asrvsn/mmi/bom.xlsx

Sheet: BOM
Component | Name | Required per unit | X units | Quantity obtained | Ordered | Total cost | Link | Supplier | Notes
Controller | Raspberry Pi 5, 2 GB (SC1642) | 1 | 1 |  | FALSE |  | https://thepihut.com/products/raspberry-pi-5?variant=43878483198147 | The Pi Hut | The desk-side controller. Any PC with an Ethernet port can drive the unit instead. Needs a 5 V 3 A USB-C supply (the USB-C plugs under Global).
Controller | Lexar 64 GB microSD card | 1 | 1 |  | FALSE |  | https://www.amazon.co.uk/dp/B0BX9BH17W | Amazon | For the Raspberry Pi.
Controller | Pimoroni HyperPixel 4.0 display, 800 x 480, touchscreen (PIM369) | 1 | 1 |  | FALSE |  | https://thepihut.com/products/hyperpixel?variant=696832262161 | The Pi Hut | The controller's status display, on the Pi's 40-pin header. The non-touch version (PIM370) works too.
Controller | Raspberry Pi Micro-HDMI to HDMI cable, 2 m, black (SC0532) | 1 | 1 |  | FALSE |  | https://thepihut.com/products/micro-hdmi-to-standard-hdmi-a-cable?variant=31597425033278 | The Pi Hut | From the Pi 5 to a desk monitor. The Pi 5's video ports are micro-HDMI, not mini-HDMI. A 1 m version also exists (black SC0546, white SC0358).
Controller | 8BitDo Ultimate 2C Wired controller (PC/Android): Hall effect sticks and triggers, 1000 Hz, USB | 1 | 1 |  | FALSE |  | https://www.amazon.co.uk/dp/B0D72WYT8Z?th=1 | Amazon | The hand controls, on the Pi's USB. Hall-effect sticks don't drift the way potentiometer sticks do. Also at Scan, LN154462.
Global | Neodymium disc magnet, 8 x 3 mm, N42, axially magnetised, Ni-Cu-Ni (MS0118) | 9 | 3 |  | FALSE |  | https://magnetstore.co.uk/disc-magnets/8mm-x-3mm-neodymium-disc-magnet-n42/ | Magnet Store | 9 per unit, one under each V-slot of the three magnetic kinematic couplings.
Global | Dowel pin, 2 x 10 mm, DIN 6325 m6, hardened and ground steel | 24 | 3 |  | FALSE |  | https://springfasteners.co.uk/product/solid-dowel-pin-din-6325-2mm-x-10mm/ | Spring Fasteners | 24 per unit: 4 kinematic couplings x 3 contacts x 2 dowels. Must be magnetic: hardened steel, not A1/A2/A4 stainless. Sold in packs of 5-100.
Global | Steel ball, 8 mm, AISI 440C, grade G100 | 12 | 3 |  | FALSE |  | https://www.ballandrollerstore.com/stainless-steel-aisi-440c-ball-bearings/8mm-aisi-440c/ | Ball and Roller Store | 12 per unit: 4 kinematic couplings x 3 contacts. 440C is hard, magnetic and corrosion resistant.
Global | Formlabs Rigid 4000 resin, 1 L cartridge | 2 | 1 |  | FALSE |  | https://www.additive-x.com/shop/form-2-rigid-4000-resin-cartridge-1l.html | Additive-X | For the printed parts (Form 3L).
Global | VooGenzek PCB prototyping kit: 20 perfboards, 2/3-pin screw terminals, male and female pin headers | 1 | 1 |  | FALSE |  | https://www.amazon.co.uk/dp/B09NDP48TX | Amazon | Used for its 2.54 mm pin headers: male for Teensys without pre-assembled headers and the head board's 2x3 test header; female for the Teensy's sockets on the main board, 2 x 1x24 per unit, each cut from a 1x40 strip. Its 8.4 mm female strips work in place of 8.5 mm. More strips in the header kit, next row.
Global | GLARKS 2.54 mm pin header kit, 40 pcs in 8 kinds: 1x40 and 2x40 male, straight and right-angle; 1x40 and 2x40 female; round-pin male and female | 1 | 1 |  | FALSE |  | https://www.amazon.co.uk/dp/B01GY36RJY | Amazon | General header stock, 5 strips of each kind. Its straight female strips add to the VooGenzek kit's for the Teensy's sockets: use the square-pin ones there, not the round-pin. Contents taken from SunFounder's listing of the same kit, so check on arrival.
Global | TUOFENG 26 AWG silicone wire, 6 colours x 10 m | 1 | 1 |  | FALSE |  | https://www.amazon.co.uk/dp/B07G732HNX | Amazon | One set per build: the lid cable (7 strands), the LED strip leads and the head's short motor and switch wires.
Global | Heat-shrink tubing assortment, 2:1, 560 pcs | 1 | 1 |  | FALSE |  | https://www.amazon.co.uk/dp/B092VWZN4W | Amazon | One set per build. Covers the lid cable's solder joints.
Global | 900Pcs Bolts and Nuts Set,M2 M2.5 M3 | 1 | 1 |  | FALSE |  | https://www.amazon.co.uk/dp/B0F38BVTWW | Amazon | The build's M2, M2.5 and M3 screws and nuts. Per unit: 3 x M2.5 screws with nuts or standoffs for the main board, 6 x M3 nuts for the top plate, and M2 screws and nuts for the holder clamp, head board and wrist clamp. The wrist clamp also needs 2 x M2 x 7 countersunk screws per unit, bought separately. Check the kit's lengths on arrival.
Global | M3-0.5x6mm Button Head Socket Cap Screws | 1 | 1 |  | FALSE |  | https://www.amazon.co.uk/dp/B0CNR3XJM9 | Amazon | 6 per unit, for the top plate. Pan or button head: countersunk heads won't seat in the plate's holes. Check the pack covers all your units.
Global | Gocableties cable ties, 100 x 2.5 mm, pack of 100 | 1 | 1 |  | FALSE |  | https://www.amazon.co.uk/dp/B072SLJR2T | Amazon | The head board's ribbon strain relief, plus cable dressing. One pack covers all units.
Global | 1DFAUL conformal coating for electronics, 200 ml | 1 | 1 |  | FALSE |  | https://www.amazon.co.uk/dp/B0FH28CQ2Q?th=1 | Amazon | For the boards. One bottle covers all units.
Global | USB-C PD charger plug, 20 W, UK, 3-pack | 1 | 1 |  | FALSE |  | https://www.amazon.co.uk/dp/B0CFFDWMWZ | Amazon | The Raspberry Pi 5's supply, in place of the official 27 W (SC1154). It must supply 5 V at 3 A, so check the label. If USB-C cables don't come with the plugs, add a USB-C to USB-C cable rated 3 A. One 3-pack covers 3 controllers.
Global | Araldite Standard 2-part epoxy, slow cure, 2 x 15 ml tubes (ARA-400001) | 1 | 1 |  | FALSE |  | https://www.amazon.co.uk/dp/B0F8BJ1MX4 | Amazon | Slow-cure 2-part epoxy, for setting the kinematic coupling hardware (balls, dowels, magnets) into the printed parts. One pack covers all units. Agilent Torr Seal works as a substitute. Avoid fast-setting urethanes such as J-B Weld PlasticBonder: they creep at the coupling seats.
Global | Synthetic grease | 1 | 1 |  | FALSE |  | https://www.amazon.co.uk/dp/B000XBH9HI | Amazon
Global | M4 x 8 mm countersunk bolts, pack of 20 | 3 | 1 |  | FALSE |  | https://www.amazon.co.uk/dp/B0FD2XSKKP | Amazon | Counted in packs: 3 packs of 20.
Global | M4 x 10 mm countersunk bolts, pack of 20 | 3 | 1 |  | FALSE |  | https://www.amazon.co.uk/dp/B0FD316BX3 | Amazon | Counted in packs: 3 packs of 20.
Head | Miniature linear stage, MAX-B34C-13S | 3 | 3 |  | FALSE |  | https://optics-focus.com/product/miniature-linear-stage-1777569712/ | Optics-focus | Non-micrometer version. Older product page: https://optics-focus.com/miniature-linear-stage-p-206.html
Head | INJORA INJS11 11 kg coreless digital micro servo (INJS11GD) | 5 | 2 |  | FALSE |  | https://www.amazon.co.uk/dp/B0FKMPXRCS | Amazon | Bottom wire exit variant. Used as a gearmotor: the servo board is bypassed.
Head | Omron D2F-01FL microswitch, SPDT, hinge lever, low force, gold contacts, PCB terminals | 10 | 4 |  | FALSE |  | https://www.digikey.co.uk/en/products/detail/omron-electronics-inc-emc-div/D2F-01FL/368431 | DigiKey | The head's limit switches, 8 per unit. Low operating force (<= 0.25 N) so it doesn't fight the stages' return springs. Omron's switch line is now sold as Aratas. DigiKey SW858-ND.
Head | Stainless steel balls, 6 mm, G25, 120 pcs | 1 | 1 |  | FALSE |  | https://www.amazon.co.uk/dp/B0GHLXD2JL | Amazon | One pack of 120. A ball that sits on a magnet must be magnetic: 440C or chrome steel, not 304/316 stainless.
Head | Neodymium disc magnet, 6 x 2 mm, N42, 20 pcs | 1 | 1 |  | FALSE |  | https://www.amazon.co.uk/dp/B003MWC1CS | Amazon | One pack of 20.
Head | Neodymium disc magnet, 6 x 3 mm, N42, 20 pcs | 1 | 1 |  | FALSE |  | https://www.amazon.co.uk/dp/B015UQKQQG | Amazon | One pack of 20.
Lid | BQLZR TES1-4902 Peltier module, 20 x 20 x 4 mm, 6 V 2 A, pack of 2 | 5 | 1 |  | FALSE |  | https://www.amazon.co.uk/dp/B0998KCDHK | Amazon | Counted in packs: 3 packs per unit for the lid's six Peltiers (in series). They must be 4.0 mm thick: the top plate sits flush only with 4.0 mm modules. Single-module spares: sourcing map TES1-4902, https://www.amazon.co.uk/dp/B0D1N1H1BR
Lid | TES1-4902 Peltier module, 20 x 20 mm, 6 V 2 A (second supplier) | 2 | 1 |  | FALSE |  | https://www.amazon.co.uk/dp/B098JTRFQ6 | Amazon | A second source for the same module, if the BQLZR packs (previous row) run short. Pack size not checked. Must be 4.0 mm thick. A lid's six Peltiers run in series, so keep each lid's six from one supplier.
Lid | TEWA TT4-G10KC3-T180-C312-200 NTC probe, 10k, 1 %, B 3977, stainless cap 3 x 12 mm, 200 mm PTFE leads | 2 | 5 |  | FALSE |  | https://www.digikey.co.uk/en/products/detail/tewa-sensors-llc/TT4-G10KC3-T180-C312-200/12419127 | DigiKey | The medium temperature probes, 2 per unit. Glass NTC in a 3 mm stainless cap, -40 to 180 C. DigiKey 1912-TT4-G10KC3-T180-C312-200-ND.
Lid | ARCTIC MX-4 thermal paste, 8 g | 1 | 1 |  | FALSE |  | https://www.amazon.co.uk/dp/B07LF66ZSV | Amazon | For the Peltiers. One 8 g syringe covers all units.
Lid | Rust-Oleum Painter's Touch spray paint, matt black, 400 ml | 1 | 1 |  | FALSE |  | https://www.amazon.co.uk/dp/B001W03PH2 | Amazon | For the lid board's aluminium underside. One can covers all units. Any matt black that dries at room temperature works; avoid metallic, graphite or conductive paints, and heat-cure (VHT / High Heat) paints. Also needed: a fine abrasive pad or 600-grit paper, masking tape and paper. The same can at B&Q: https://www.diy.com/departments/rust-oleum-painter-s-touch-black-matt-multi-surface-decorative-spray-paint-400ml/128301_BQ.prd. On an RS order instead: RS PRO 764-3039, https://uk.rs-online.com/web/p/spray-paint/7643039
Lid | Polyimide (Kapton) tape, 15 mm x ~33 m, amber, single-sided | 1 | 1 |  | FALSE |  | https://thepihut.com/products/polyimide-tape?variant=42183571833027 | The Pi Hut | Small pieces under the lid frame's nuts. One roll covers all units. Generic tape is about 0.06 mm thick; up to 0.1 mm works. Pi Hut SKU 105239. Branded alternative, 0.069 mm: 3M 5413 at DigiKey, https://www.digikey.co.uk/en/products/detail/3m/5413-AMBER-1-4-IN-X-36-Y/1819260
Main | Linear stage with NEMA11 stepper, 150 mm stroke, T6x1 lead screw, MGN9 rail | 1 | 3 |  | FALSE |  | https://www.amazon.co.uk/dp/B08Y6YR45F | Amazon | The X coarse rail. Keep the 1 mm lead (T6x1). A generic design made by several factories, so buy all units from one seller in one order.
Main | Teensy 4.1 with Ethernet, pre-assembled headers (PJRC DEV-16996) | 1 | 3 |  | FALSE |  | https://thepihut.com/products/teensy-4-1-with-assembled-pins?variant=37627618066627 | The Pi Hut | The main board's MCU. Also needs the PJRC Ethernet kit (next row) and a Schottky diode for the VUSB-VIN modification (the 1N5819HW, under Main).
Main | PJRC Ethernet Kit for Teensy 4.1: MagJack, bare adaptor board, 6-wire cable, two 2x3 2 mm headers, capacitor | 1 | 3 |  | FALSE |  | https://thepihut.com/products/ethernet-kit-for-teensy-4-1?variant=37627737669827 | The Pi Hut | 1 per unit. Supplies the MagJack, the two 2x3 2 mm headers and the 6-wire cable; the adaptor board and capacitor aren't used.
Main | Ultra-slim Cat6 Ethernet cable, 2.8 mm OD, 3 m, 6-pack | 1 | 1 |  | FALSE |  | https://www.amazon.co.uk/dp/B0FC2N8718 | Amazon | The unit's data link. One 6-pack covers up to 6 units. Avoid flat Ethernet cable: it's stiff in one direction and twists. Faster-delivery fallback: Dutevolns ultra-thin Cat6A, 3.2 mm OD, 3 m, 2-pack, https://www.amazon.co.uk/dp/B0DXT9CQGD
Main | KEXIN 16 GB microSDHC card, Class 10 UHS-I, 5-pack, with SD adapter | 1 | 1 |  | FALSE |  | https://www.amazon.co.uk/dp/B097TBKXZL | Amazon | Counted in packs: one 5-pack covers 3 Teensys' microSD slots, with 2 spares.
Main | Würth 61202021621 WR-BHD box header, 2x10, 2.54 mm, shrouded, straight, through-hole | 1 | 10 |  | FALSE |  | https://www.digikey.co.uk/en/products/detail/w%C3%BCrth-elektronik/61202021621/2060592 | DigiKey | J1, the head ribbon's header, 1 per unit; a spare makes the ribbon test plug. Any straight shrouded 2x10 2.54 mm box header fits, e.g. Sullins SBH11-PBPC-D10-ST-BK (S9172-ND). DigiKey 732-2096-ND.
Main | Panasonic EEU-FR1H101 electrolytic capacitor, 100 uF 50 V, low ESR, radial 8 x 11.5 mm, 3.5 mm pitch | 2 | 10 |  | FALSE |  | https://www.digikey.co.uk/en/products/detail/panasonic-electronic-components/EEU-FR1H101/2433588 | DigiKey | C3 and C12, 2 per unit, hand-fitted. If it's out of stock, the EEU-FM1H101 (P12392-ND) has the same 8 x 11.5 mm can and 3.5 mm pitch. DigiKey P14454-ND.
Main | Diodes Inc 1N5819HW-7-F Schottky diode, SOD-123, 1 A 40 V | 1 | 10 |  | FALSE |  | https://www.digikey.co.uk/en/products/detail/diodes-incorporated/1N5819HW-7-F/815283 | DigiKey | Teensy modification, 1 per unit: bridges the cut VUSB-VIN pads. Any SOD-123 Schottky of 0.5 A or more works, such as the B5819W. DigiKey 1N5819HW-FDICT-ND (cut tape).
Main | Same Sky (CUI) PJ-063AH barrel jack, 5.5 mm, 2.0 mm pin, 8 A, 24 V DC, PCB horizontal | 1 | 10 |  | FALSE |  | https://www.digikey.co.uk/en/products/detail/same-sky-formerly-cui-devices/PJ-063AH/2161208 | DigiKey | J15, the 24 V input, 1 per unit. Order it with its plug (next row). Breadboard-style 2.1 mm jacks don't fit the footprint. DigiKey CP-063AH-ND.
Main | Same Sky (CUI) PP3-002AH DC plug, 5.5 x 2.1 mm, 14 mm barrel, solder eyelets, screw-on cover | 1 | 10 |  | FALSE |  | https://www.digikey.co.uk/en/products/detail/same-sky-formerly-cui-devices/PP3-002AH/2197311 | DigiKey | J15's mating plug, rated 24 V DC / 8 A. Cable OD 4 mm max. DigiKey CP3-002AH-ND. Not the PP3-002A: its 9.5 mm barrel fouls the board, and it's rated only 20 V.
Main | Haerkn 22 AWG silicone 2-core cable, 10 m | 1 | 1 |  | FALSE |  | https://www.amazon.co.uk/dp/B07TT52X28 | Amazon | The 24 V lead from the power supply to the DC plug. One 10 m reel gives 5 units a 2 m lead each. The plug cover takes cable up to 4 mm OD, so check the OD on arrival.
Main | Mean Well LRS-350-24 power supply, 24 V 14.6 A, 350 W, enclosed | 1 | 1 |  | FALSE |  | https://www.digikey.co.uk/en/products/detail/mean-well-usa-inc/LRS-350-24/7705034 | DigiKey | The unit's power supply. Its mains input is screw terminals, so it needs the mains lead (next row). DigiKey 1866-3346-ND. Also at RS UK, 106-5869: https://uk.rs-online.com/web/p/switching-power-supplies/1065869
Main | GlobTek 6104136F000 mains lead, UK plug (BS1363) to bare cable, H05RN-F, 17 AWG, 1.86 m, black | 1 | 1 |  | FALSE |  | https://www.digikey.co.uk/en/products/detail/globtek-inc/6104136F000/9837738 | DigiKey | The power supply's mains lead: UK plug to bare cores for its L, N and earth terminals. One per supply. DigiKey 1939-1673-ND.
Main | JST S7B-PH-K-S header, PH 7-pin, 2.0 mm, side entry, through-hole | 1 | 10 |  | FALSE |  | https://www.digikey.co.uk/en/products/detail/jst-sales-america-inc/S7B-PH-K-S/926631 | DigiKey | J20, the lid port. A spare makes the lid test plug. DigiKey 455-1724-ND.
Main | JST S3B-PH-SM4-TB header, PH 3-pin, 2.0 mm, side entry, SMD | 1 | 10 |  | FALSE |  | https://www.digikey.co.uk/en/products/detail/jst-sales-america-inc/S3B-PH-SM4-TB/926656 | DigiKey | J16, the LED strip port, hand-soldered. DigiKey 455-S3B-PH-SM4-TBCT-ND (cut tape).
Main | WeLoveLEDs COB CCT LED strip, 24 V, 608 LEDs/m, 7 W/m, 10 mm wide (sold per metre) | 1 | 1 |  | FALSE |  | https://www.weloveleds.co.uk/products/cob-cct-led-strip-24v-608leds-7w | WeLoveLEDs | 1 m covers the build. It cuts every 50 mm. Per-metre cuts come without guaranteed leads, so plan to solder your own.
Main | JST S4B-ZR-SM4A-TF header, ZH 4-pin, 1.5 mm, side entry, SMD | 1 | 10 |  | FALSE |  | https://www.digikey.co.uk/en/products/detail/jst-sales-america-inc/S4B-ZR-SM4A-TF/926602 | DigiKey | J3, the rail motor port, hand-soldered. DigiKey 455-S4B-ZR-SM4A-TFCT-ND (cut tape).
Main | JST PHR-7 housing, PH 7-pin, 2.0 mm | 1 | 10 |  | FALSE |  | https://www.digikey.co.uk/en/products/detail/jst-sales-america-inc/PHR-7/608603 | DigiKey | The lid cable's plug for J20. Takes halves of the pre-crimped ASPHSPH24K305 leads, so no crimp tool is needed. DigiKey 455-1161-ND.
Main | JST PHR-3 housing, PH 3-pin, 2.0 mm | 1 | 10 |  | FALSE |  | https://www.digikey.co.uk/en/products/detail/jst-sales-america-inc/PHR-3/527357 | DigiKey | The LED strip's plug for J16, 1 per unit, with halves of the ASPHSPH24K305 leads. Genuine JST, so it mates J16 exactly. DigiKey 455-1126-ND.
Main | JST ASPHSPH24K305 pre-crimped PH lead, 24 AWG, 305 mm, socket both ends | 6 | 5 |  | FALSE |  | https://www.digikey.co.uk/en/products/detail/jst-sales-america-inc/ASPHSPH24K305/6009459 | DigiKey | Pre-crimped wires for the PHR-7 and PHR-3, so no PH crimp tool is needed: each lead cut in half gives two crimped wires. 6 per set: 4 for the lid cable, 2 for the LED strip plug. DigiKey 455-3083-ND.
Main | JST ZHR-4 housing, ZH 4-pin, 1.5 mm | 1 | 10 |  | FALSE |  | https://www.digikey.co.uk/en/products/detail/jst-sales-america-inc/ZHR-4/608643 | DigiKey | The rail motor cable's plug for J3, 1 per unit, with the ASZHSZH28K305 leads. Genuine JST, so it mates J3 exactly. DigiKey 455-1202-ND.
Main | JST ASZHSZH28K305 pre-crimped ZH lead, 28 AWG, 305 mm, socket both ends | 2 | 10 |  | FALSE |  | https://www.digikey.co.uk/en/products/detail/jst-sales-america-inc/ASZHSZH28K305/6009456 | DigiKey | Pre-crimped wires for the ZHR-4, so no ZH crimp tool is needed: each lead cut in half gives two crimped wires, so 2 per cable. Use 4 uncut if the run to the motor is longer. DigiKey 455-3080-ND.
Main | 3M M3AAA-2018J IDC cable, 20-way, socket to socket, 457 mm (18 in) | 1 | 5 |  | FALSE |  | https://www.digikey.co.uk/en/products/detail/3m/M3AAA-2018J/229980 | DigiKey | The head cable, 1 per unit. DigiKey M3AAA-2018J-ND.
Main | sourcing map silicone solid cord, 2 mm, 10m | 1 | 1 |  | FALSE |  | https://www.amazon.co.uk/dp/B0DM5ZPQFH?th=1 | Amazon | The capillary clamp lid's cord, about 0.22 m per unit, so one length covers all units. Despite the listing's 'solid', it's a solid-section sponge, not solid rubber.
Main | C&K SK-12D07-VG 4 NS PA slide switch, SPDT, right angle, through-hole, 2.0 mm pitch, 4 mm handle | 3 | 10 |  | FALSE |  | https://www.digikey.co.uk/en/products/detail/c-k/SK-12D07-VG-4-NS-PA/3861707 | DigiKey | SW9-SW11 (power, lid heater, motors), 3 per unit. DigiKey 108-SK-12D07-VG4NSPA-ND.
Experiment | Hamilton 1000 Series Gastight syringe, 2.5 mL, threaded plunger, Luer tip, Model 1002 TPLT (Hamilton 81441) |  |  |  | FALSE |  | https://www.hamiltoncompany.com/syringes/81441 | Hamilton | Buy as needed; not counted per unit. Luer slip tip, not Luer lock: it push-fits the stopcock's female Luer. No needle included.
Experiment | Cole-Parmer disposable 3-way stopcock, polycarbonate, female x female x male locking Luer, pack of 100 |  |  |  | FALSE |  | https://www.coleparmer.co.uk/i/cole-parmer-disposable-3-way-stopcock-pc-female-x-female-x-male-locking-100-pk/4852336 | Cole-Parmer | Buy as needed; not counted per unit. Cole-Parmer 4852336. Smaller pack: TICOMI 3-way stopcocks with Luer connections, 16-pack, https://www.amazon.co.uk/dp/B0C28HCDZB
Experiment | Tygon E-3603 tubing, 1/16 in ID x 1/8 in OD, 50 ft (Saint-Gobain ACF00002) |  |  |  | FALSE |  | https://www.coleparmer.co.uk/i/tygon-e-3603-tubing-1-16-id-x-1-8-od-50-ft/5010621 | Cole-Parmer | Buy as needed; not counted per unit. Cole-Parmer 5010621. Luer to 1/16 in barb fittings: Cole-Parmer 5010975 (female Luer) and 5011011 (male Luer lock), 10 per pack.
Experiment | Nunc OmniTray single-well plate, non-treated, polystyrene, SBS footprint 128 x 86 mm, with lid, case of 60 (Thermo 242811) |  |  |  | FALSE |  | https://www.fishersci.co.uk/shop/products/nunc-omnitray/10318181 | Fisher Scientific | Buy as needed; not counted per unit. Fisher 10318181. The coverslips (next row) are glued to it with NOA 81 (the row after).
Experiment | Fisherbrand borosilicate coverslips, 22 x 50 mm, No. 1.5 (0.16-0.19 mm), pack of 100 |  |  |  | FALSE |  | https://www.fishersci.co.uk/shop/products/borosilicate-glass-no-1-coverslip-1/12383138 | Fisher Scientific | Buy as needed; not counted per unit. Fisher 12383138 is the No. 1.5; the No. 1 (0.13-0.16 mm) is Fisher 12373128. Larger alternative: Epredia 38 x 50 mm No. 1 (Fisher 16319925).
Experiment | Norland Optical Adhesive NOA 81, UV-curing, 1 oz bottle |  |  |  | FALSE |  | https://www.edmundoptics.co.uk/p/1-oz-application-bottle-of-noa-81/4179/ | Edmund Optics | Buy as needed; not counted per unit. Glues the coverslips to the OmniTray, chosen for its low viscosity (about 300 cps). Its adhesion to plastic is rated only 'fair' and the OmniTray is polystyrene, so test on an offcut first. Fallback: NOA 68, rated 'good to excellent' on plastic, https://www.edmundoptics.co.uk/p/1-oz-application-bottle-of-noa-68/4178/. Cures with 320-380 nm UV (peak 365 nm).
Experiment | Borosilicate glass capillaries, standard wall, with filament, 2.00 mm OD x 1.00 mm ID, 10 cm, 225 per pack (BF200-100-10) |  |  |  | FALSE |  | https://www.wpi-europe.com/products/glass/glass-capillaries/single-barrel-borosilicate-glass-capillaries.aspx | WPI | Buy as needed; not counted per unit. The 2 mm OD glass the design is drawn for. A Sutter part number resold by WPI Europe: pick BF200-100-10 in the page's options table.

Sheet: By supplier
Component | Name | Quantity to order | Ordered | Link | Supplier | Notes
Additive-X | 1 line to order
Global | Formlabs Rigid 4000 resin, 1 L cartridge | 2 |  | https://www.additive-x.com/shop/form-2-rigid-4000-resin-cartridge-1l.html | Additive-X | For the printed parts (Form 3L).
Amazon | 28 lines to order
Controller | Lexar 64 GB microSD card | 1 |  | https://www.amazon.co.uk/dp/B0BX9BH17W | Amazon | For the Raspberry Pi.
Controller | 8BitDo Ultimate 2C Wired controller (PC/Android): Hall effect sticks and triggers, 1000 Hz, USB | 1 |  | https://www.amazon.co.uk/dp/B0D72WYT8Z?th=1 | Amazon | The hand controls, on the Pi's USB. Hall-effect sticks don't drift the way potentiometer sticks do. Also at Scan, LN154462.
Global | VooGenzek PCB prototyping kit: 20 perfboards, 2/3-pin screw terminals, male and female pin headers | 1 |  | https://www.amazon.co.uk/dp/B09NDP48TX | Amazon | Used for its 2.54 mm pin headers: male for Teensys without pre-assembled headers and the head board's 2x3 test header; female for the Teensy's sockets on the main board, 2 x 1x24 per unit, each cut from a 1x40 strip. Its 8.4 mm female strips work in place of 8.5 mm. More strips in the header kit, next row.
Global | GLARKS 2.54 mm pin header kit, 40 pcs in 8 kinds: 1x40 and 2x40 male, straight and right-angle; 1x40 and 2x40 female; round-pin male and female | 1 |  | https://www.amazon.co.uk/dp/B01GY36RJY | Amazon | General header stock, 5 strips of each kind. Its straight female strips add to the VooGenzek kit's for the Teensy's sockets: use the square-pin ones there, not the round-pin. Contents taken from SunFounder's listing of the same kit, so check on arrival.
Global | TUOFENG 26 AWG silicone wire, 6 colours x 10 m | 1 |  | https://www.amazon.co.uk/dp/B07G732HNX | Amazon | One set per build: the lid cable (7 strands), the LED strip leads and the head's short motor and switch wires.
Global | Heat-shrink tubing assortment, 2:1, 560 pcs | 1 |  | https://www.amazon.co.uk/dp/B092VWZN4W | Amazon | One set per build. Covers the lid cable's solder joints.
Global | 900Pcs Bolts and Nuts Set,M2 M2.5 M3 | 1 |  | https://www.amazon.co.uk/dp/B0F38BVTWW | Amazon | The build's M2, M2.5 and M3 screws and nuts. Per unit: 3 x M2.5 screws with nuts or standoffs for the main board, 6 x M3 nuts for the top plate, and M2 screws and nuts for the holder clamp, head board and wrist clamp. The wrist clamp also needs 2 x M2 x 7 countersunk screws per unit, bought separately. Check the kit's lengths on arrival.
Global | M3-0.5x6mm Button Head Socket Cap Screws | 1 |  | https://www.amazon.co.uk/dp/B0CNR3XJM9 | Amazon | 6 per unit, for the top plate. Pan or button head: countersunk heads won't seat in the plate's holes. Check the pack covers all your units.
Global | Gocableties cable ties, 100 x 2.5 mm, pack of 100 | 1 |  | https://www.amazon.co.uk/dp/B072SLJR2T | Amazon | The head board's ribbon strain relief, plus cable dressing. One pack covers all units.
Global | 1DFAUL conformal coating for electronics, 200 ml | 1 |  | https://www.amazon.co.uk/dp/B0FH28CQ2Q?th=1 | Amazon | For the boards. One bottle covers all units.
Global | USB-C PD charger plug, 20 W, UK, 3-pack | 1 |  | https://www.amazon.co.uk/dp/B0CFFDWMWZ | Amazon | The Raspberry Pi 5's supply, in place of the official 27 W (SC1154). It must supply 5 V at 3 A, so check the label. If USB-C cables don't come with the plugs, add a USB-C to USB-C cable rated 3 A. One 3-pack covers 3 controllers.
Global | Araldite Standard 2-part epoxy, slow cure, 2 x 15 ml tubes (ARA-400001) | 1 |  | https://www.amazon.co.uk/dp/B0F8BJ1MX4 | Amazon | Slow-cure 2-part epoxy, for setting the kinematic coupling hardware (balls, dowels, magnets) into the printed parts. One pack covers all units. Agilent Torr Seal works as a substitute. Avoid fast-setting urethanes such as J-B Weld PlasticBonder: they creep at the coupling seats.
Global | Synthetic grease | 1 |  | https://www.amazon.co.uk/dp/B000XBH9HI | Amazon
Global | M4 x 8 mm countersunk bolts, pack of 20 | 3 |  | https://www.amazon.co.uk/dp/B0FD2XSKKP | Amazon | Counted in packs: 3 packs of 20.
Global | M4 x 10 mm countersunk bolts, pack of 20 | 3 |  | https://www.amazon.co.uk/dp/B0FD316BX3 | Amazon | Counted in packs: 3 packs of 20.
Head | INJORA INJS11 11 kg coreless digital micro servo (INJS11GD) | 10 |  | https://www.amazon.co.uk/dp/B0FKMPXRCS | Amazon | Bottom wire exit variant. Used as a gearmotor: the servo board is bypassed.
Head | Stainless steel balls, 6 mm, G25, 120 pcs | 1 |  | https://www.amazon.co.uk/dp/B0GHLXD2JL | Amazon | One pack of 120. A ball that sits on a magnet must be magnetic: 440C or chrome steel, not 304/316 stainless.
Head | Neodymium disc magnet, 6 x 2 mm, N42, 20 pcs | 1 |  | https://www.amazon.co.uk/dp/B003MWC1CS | Amazon | One pack of 20.
Head | Neodymium disc magnet, 6 x 3 mm, N42, 20 pcs | 1 |  | https://www.amazon.co.uk/dp/B015UQKQQG | Amazon | One pack of 20.
Lid | BQLZR TES1-4902 Peltier module, 20 x 20 x 4 mm, 6 V 2 A, pack of 2 | 5 |  | https://www.amazon.co.uk/dp/B0998KCDHK | Amazon | Counted in packs: 3 packs per unit for the lid's six Peltiers (in series). They must be 4.0 mm thick: the top plate sits flush only with 4.0 mm modules. Single-module spares: sourcing map TES1-4902, https://www.amazon.co.uk/dp/B0D1N1H1BR
Lid | TES1-4902 Peltier module, 20 x 20 mm, 6 V 2 A (second supplier) | 2 |  | https://www.amazon.co.uk/dp/B098JTRFQ6 | Amazon | A second source for the same module, if the BQLZR packs (previous row) run short. Pack size not checked. Must be 4.0 mm thick. A lid's six Peltiers run in series, so keep each lid's six from one supplier.
Lid | ARCTIC MX-4 thermal paste, 8 g | 1 |  | https://www.amazon.co.uk/dp/B07LF66ZSV | Amazon | For the Peltiers. One 8 g syringe covers all units.
Lid | Rust-Oleum Painter's Touch spray paint, matt black, 400 ml | 1 |  | https://www.amazon.co.uk/dp/B001W03PH2 | Amazon | For the lid board's aluminium underside. One can covers all units. Any matt black that dries at room temperature works; avoid metallic, graphite or conductive paints, and heat-cure (VHT / High Heat) paints. Also needed: a fine abrasive pad or 600-grit paper, masking tape and paper. The same can at B&Q: https://www.diy.com/departments/rust-oleum-painter-s-touch-black-matt-multi-surface-decorative-spray-paint-400ml/128301_BQ.prd. On an RS order instead: RS PRO 764-3039, https://uk.rs-online.com/web/p/spray-paint/7643039
Main | Linear stage with NEMA11 stepper, 150 mm stroke, T6x1 lead screw, MGN9 rail | 3 |  | https://www.amazon.co.uk/dp/B08Y6YR45F | Amazon | The X coarse rail. Keep the 1 mm lead (T6x1). A generic design made by several factories, so buy all units from one seller in one order.
Main | Ultra-slim Cat6 Ethernet cable, 2.8 mm OD, 3 m, 6-pack | 1 |  | https://www.amazon.co.uk/dp/B0FC2N8718 | Amazon | The unit's data link. One 6-pack covers up to 6 units. Avoid flat Ethernet cable: it's stiff in one direction and twists. Faster-delivery fallback: Dutevolns ultra-thin Cat6A, 3.2 mm OD, 3 m, 2-pack, https://www.amazon.co.uk/dp/B0DXT9CQGD
Main | KEXIN 16 GB microSDHC card, Class 10 UHS-I, 5-pack, with SD adapter | 1 |  | https://www.amazon.co.uk/dp/B097TBKXZL | Amazon | Counted in packs: one 5-pack covers 3 Teensys' microSD slots, with 2 spares.
Main | Haerkn 22 AWG silicone 2-core cable, 10 m | 1 |  | https://www.amazon.co.uk/dp/B07TT52X28 | Amazon | The 24 V lead from the power supply to the DC plug. One 10 m reel gives 5 units a 2 m lead each. The plug cover takes cable up to 4 mm OD, so check the OD on arrival.
Main | sourcing map silicone solid cord, 2 mm, 10m | 1 |  | https://www.amazon.co.uk/dp/B0DM5ZPQFH?th=1 | Amazon | The capillary clamp lid's cord, about 0.22 m per unit, so one length covers all units. Despite the listing's 'solid', it's a solid-section sponge, not solid rubber.
Ball and Roller Store | 1 line to order
Global | Steel ball, 8 mm, AISI 440C, grade G100 | 36 |  | https://www.ballandrollerstore.com/stainless-steel-aisi-440c-ball-bearings/8mm-aisi-440c/ | Ball and Roller Store | 12 per unit: 4 kinematic couplings x 3 contacts. 440C is hard, magnetic and corrosion resistant.
DigiKey | 19 lines to order
Head | Omron D2F-01FL microswitch, SPDT, hinge lever, low force, gold contacts, PCB terminals | 40 |  | https://www.digikey.co.uk/en/products/detail/omron-electronics-inc-emc-div/D2F-01FL/368431 | DigiKey | The head's limit switches, 8 per unit. Low operating force (<= 0.25 N) so it doesn't fight the stages' return springs. Omron's switch line is now sold as Aratas. DigiKey SW858-ND.
Lid | TEWA TT4-G10KC3-T180-C312-200 NTC probe, 10k, 1 %, B 3977, stainless cap 3 x 12 mm, 200 mm PTFE leads | 10 |  | https://www.digikey.co.uk/en/products/detail/tewa-sensors-llc/TT4-G10KC3-T180-C312-200/12419127 | DigiKey | The medium temperature probes, 2 per unit. Glass NTC in a 3 mm stainless cap, -40 to 180 C. DigiKey 1912-TT4-G10KC3-T180-C312-200-ND.
Main | Würth 61202021621 WR-BHD box header, 2x10, 2.54 mm, shrouded, straight, through-hole | 10 |  | https://www.digikey.co.uk/en/products/detail/w%C3%BCrth-elektronik/61202021621/2060592 | DigiKey | J1, the head ribbon's header, 1 per unit; a spare makes the ribbon test plug. Any straight shrouded 2x10 2.54 mm box header fits, e.g. Sullins SBH11-PBPC-D10-ST-BK (S9172-ND). DigiKey 732-2096-ND.
Main | Panasonic EEU-FR1H101 electrolytic capacitor, 100 uF 50 V, low ESR, radial 8 x 11.5 mm, 3.5 mm pitch | 20 |  | https://www.digikey.co.uk/en/products/detail/panasonic-electronic-components/EEU-FR1H101/2433588 | DigiKey | C3 and C12, 2 per unit, hand-fitted. If it's out of stock, the EEU-FM1H101 (P12392-ND) has the same 8 x 11.5 mm can and 3.5 mm pitch. DigiKey P14454-ND.
Main | Diodes Inc 1N5819HW-7-F Schottky diode, SOD-123, 1 A 40 V | 10 |  | https://www.digikey.co.uk/en/products/detail/diodes-incorporated/1N5819HW-7-F/815283 | DigiKey | Teensy modification, 1 per unit: bridges the cut VUSB-VIN pads. Any SOD-123 Schottky of 0.5 A or more works, such as the B5819W. DigiKey 1N5819HW-FDICT-ND (cut tape).
Main | Same Sky (CUI) PJ-063AH barrel jack, 5.5 mm, 2.0 mm pin, 8 A, 24 V DC, PCB horizontal | 10 |  | https://www.digikey.co.uk/en/products/detail/same-sky-formerly-cui-devices/PJ-063AH/2161208 | DigiKey | J15, the 24 V input, 1 per unit. Order it with its plug (next row). Breadboard-style 2.1 mm jacks don't fit the footprint. DigiKey CP-063AH-ND.
Main | Same Sky (CUI) PP3-002AH DC plug, 5.5 x 2.1 mm, 14 mm barrel, solder eyelets, screw-on cover | 10 |  | https://www.digikey.co.uk/en/products/detail/same-sky-formerly-cui-devices/PP3-002AH/2197311 | DigiKey | J15's mating plug, rated 24 V DC / 8 A. Cable OD 4 mm max. DigiKey CP3-002AH-ND. Not the PP3-002A: its 9.5 mm barrel fouls the board, and it's rated only 20 V.
Main | Mean Well LRS-350-24 power supply, 24 V 14.6 A, 350 W, enclosed | 1 |  | https://www.digikey.co.uk/en/products/detail/mean-well-usa-inc/LRS-350-24/7705034 | DigiKey | The unit's power supply. Its mains input is screw terminals, so it needs the mains lead (next row). DigiKey 1866-3346-ND. Also at RS UK, 106-5869: https://uk.rs-online.com/web/p/switching-power-supplies/1065869
Main | GlobTek 6104136F000 mains lead, UK plug (BS1363) to bare cable, H05RN-F, 17 AWG, 1.86 m, black | 1 |  | https://www.digikey.co.uk/en/products/detail/globtek-inc/6104136F000/9837738 | DigiKey | The power supply's mains lead: UK plug to bare cores for its L, N and earth terminals. One per supply. DigiKey 1939-1673-ND.
Main | JST S7B-PH-K-S header, PH 7-pin, 2.0 mm, side entry, through-hole | 10 |  | https://www.digikey.co.uk/en/products/detail/jst-sales-america-inc/S7B-PH-K-S/926631 | DigiKey | J20, the lid port. A spare makes the lid test plug. DigiKey 455-1724-ND.
Main | JST S3B-PH-SM4-TB header, PH 3-pin, 2.0 mm, side entry, SMD | 10 |  | https://www.digikey.co.uk/en/products/detail/jst-sales-america-inc/S3B-PH-SM4-TB/926656 | DigiKey | J16, the LED strip port, hand-soldered. DigiKey 455-S3B-PH-SM4-TBCT-ND (cut tape).
Main | JST S4B-ZR-SM4A-TF header, ZH 4-pin, 1.5 mm, side entry, SMD | 10 |  | https://www.digikey.co.uk/en/products/detail/jst-sales-america-inc/S4B-ZR-SM4A-TF/926602 | DigiKey | J3, the rail motor port, hand-soldered. DigiKey 455-S4B-ZR-SM4A-TFCT-ND (cut tape).
Main | JST PHR-7 housing, PH 7-pin, 2.0 mm | 10 |  | https://www.digikey.co.uk/en/products/detail/jst-sales-america-inc/PHR-7/608603 | DigiKey | The lid cable's plug for J20. Takes halves of the pre-crimped ASPHSPH24K305 leads, so no crimp tool is needed. DigiKey 455-1161-ND.
Main | JST PHR-3 housing, PH 3-pin, 2.0 mm | 10 |  | https://www.digikey.co.uk/en/products/detail/jst-sales-america-inc/PHR-3/527357 | DigiKey | The LED strip's plug for J16, 1 per unit, with halves of the ASPHSPH24K305 leads. Genuine JST, so it mates J16 exactly. DigiKey 455-1126-ND.
Main | JST ASPHSPH24K305 pre-crimped PH lead, 24 AWG, 305 mm, socket both ends | 30 |  | https://www.digikey.co.uk/en/products/detail/jst-sales-america-inc/ASPHSPH24K305/6009459 | DigiKey | Pre-crimped wires for the PHR-7 and PHR-3, so no PH crimp tool is needed: each lead cut in half gives two crimped wires. 6 per set: 4 for the lid cable, 2 for the LED strip plug. DigiKey 455-3083-ND.
Main | JST ZHR-4 housing, ZH 4-pin, 1.5 mm | 10 |  | https://www.digikey.co.uk/en/products/detail/jst-sales-america-inc/ZHR-4/608643 | DigiKey | The rail motor cable's plug for J3, 1 per unit, with the ASZHSZH28K305 leads. Genuine JST, so it mates J3 exactly. DigiKey 455-1202-ND.
Main | JST ASZHSZH28K305 pre-crimped ZH lead, 28 AWG, 305 mm, socket both ends | 20 |  | https://www.digikey.co.uk/en/products/detail/jst-sales-america-inc/ASZHSZH28K305/6009456 | DigiKey | Pre-crimped wires for the ZHR-4, so no ZH crimp tool is needed: each lead cut in half gives two crimped wires, so 2 per cable. Use 4 uncut if the run to the motor is longer. DigiKey 455-3080-ND.
Main | 3M M3AAA-2018J IDC cable, 20-way, socket to socket, 457 mm (18 in) | 5 |  | https://www.digikey.co.uk/en/products/detail/3m/M3AAA-2018J/229980 | DigiKey | The head cable, 1 per unit. DigiKey M3AAA-2018J-ND.
Main | C&K SK-12D07-VG 4 NS PA slide switch, SPDT, right angle, through-hole, 2.0 mm pitch, 4 mm handle | 30 |  | https://www.digikey.co.uk/en/products/detail/c-k/SK-12D07-VG-4-NS-PA/3861707 | DigiKey | SW9-SW11 (power, lid heater, motors), 3 per unit. DigiKey 108-SK-12D07-VG4NSPA-ND.
Magnet Store | 1 line to order
Global | Neodymium disc magnet, 8 x 3 mm, N42, axially magnetised, Ni-Cu-Ni (MS0118) | 27 |  | https://magnetstore.co.uk/disc-magnets/8mm-x-3mm-neodymium-disc-magnet-n42/ | Magnet Store | 9 per unit, one under each V-slot of the three magnetic kinematic couplings.
Optics-focus | 1 line to order
Head | Miniature linear stage, MAX-B34C-13S | 9 |  | https://optics-focus.com/product/miniature-linear-stage-1777569712/ | Optics-focus | Non-micrometer version. Older product page: https://optics-focus.com/miniature-linear-stage-p-206.html
Spring Fasteners | 1 line to order
Global | Dowel pin, 2 x 10 mm, DIN 6325 m6, hardened and ground steel | 72 |  | https://springfasteners.co.uk/product/solid-dowel-pin-din-6325-2mm-x-10mm/ | Spring Fasteners | 24 per unit: 4 kinematic couplings x 3 contacts x 2 dowels. Must be magnetic: hardened steel, not A1/A2/A4 stainless. Sold in packs of 5-100.
The Pi Hut | 6 lines to order
Controller | Raspberry Pi 5, 2 GB (SC1642) | 1 |  | https://thepihut.com/products/raspberry-pi-5?variant=43878483198147 | The Pi Hut | The desk-side controller. Any PC with an Ethernet port can drive the unit instead. Needs a 5 V 3 A USB-C supply (the USB-C plugs under Global).
Controller | Pimoroni HyperPixel 4.0 display, 800 x 480, touchscreen (PIM369) | 1 |  | https://thepihut.com/products/hyperpixel?variant=696832262161 | The Pi Hut | The controller's status display, on the Pi's 40-pin header. The non-touch version (PIM370) works too.
Controller | Raspberry Pi Micro-HDMI to HDMI cable, 2 m, black (SC0532) | 1 |  | https://thepihut.com/products/micro-hdmi-to-standard-hdmi-a-cable?variant=31597425033278 | The Pi Hut | From the Pi 5 to a desk monitor. The Pi 5's video ports are micro-HDMI, not mini-HDMI. A 1 m version also exists (black SC0546, white SC0358).
Lid | Polyimide (Kapton) tape, 15 mm x ~33 m, amber, single-sided | 1 |  | https://thepihut.com/products/polyimide-tape?variant=42183571833027 | The Pi Hut | Small pieces under the lid frame's nuts. One roll covers all units. Generic tape is about 0.06 mm thick; up to 0.1 mm works. Pi Hut SKU 105239. Branded alternative, 0.069 mm: 3M 5413 at DigiKey, https://www.digikey.co.uk/en/products/detail/3m/5413-AMBER-1-4-IN-X-36-Y/1819260
Main | Teensy 4.1 with Ethernet, pre-assembled headers (PJRC DEV-16996) | 3 |  | https://thepihut.com/products/teensy-4-1-with-assembled-pins?variant=37627618066627 | The Pi Hut | The main board's MCU. Also needs the PJRC Ethernet kit (next row) and a Schottky diode for the VUSB-VIN modification (the 1N5819HW, under Main).
Main | PJRC Ethernet Kit for Teensy 4.1: MagJack, bare adaptor board, 6-wire cable, two 2x3 2 mm headers, capacitor | 3 |  | https://thepihut.com/products/ethernet-kit-for-teensy-4-1?variant=37627737669827 | The Pi Hut | 1 per unit. Supplies the MagJack, the two 2x3 2 mm headers and the 6-wire cable; the adaptor board and capacitor aren't used.
WeLoveLEDs | 1 line to order
Main | WeLoveLEDs COB CCT LED strip, 24 V, 608 LEDs/m, 7 W/m, 10 mm wide (sold per metre) | 1 |  | https://www.weloveleds.co.uk/products/cob-cct-led-strip-24v-608leds-7w | WeLoveLEDs | 1 m covers the build. It cuts every 50 mm. Per-metre cuts come without guaranteed leads, so plan to solder your own.

Sheet: Order links
DigiKey: add the 19 lines below to a DigiKey basket |  |  | Amazon: 28 lines, added one by one |  |  | The Pi Hut: put the 6 lines below in a Pi Hut basket
Opens DigiKey's basket with these lines in it (DigiKey FastAdd). It adds to any basket already open in that browser. |  |  | Amazon has no basket link that works without an Associates account. Each ASIN below opens its product page. To share the whole order, add these to an Amazon Shopping List and use its Send list to others link. |  |  | Opens The Pi Hut's basket with these lines in it (a Shopify cart link). It may replace anything already in that basket. A line whose link has no ?variant= is left out: add it by hand.
DigiKey part number | Quantity | Name | ASIN | Quantity | Name | Variant ID | Quantity | Name
SW858-ND | 40 | Omron D2F-01FL microswitch, SPDT, hinge lever, low force, gold contacts, PCB terminals | B0BX9BH17W | 1 | Lexar 64 GB microSD card | 43878483198147 | 1 | Raspberry Pi 5, 2 GB (SC1642)
1912-TT4-G10KC3-T180-C312-200-ND | 10 | TEWA TT4-G10KC3-T180-C312-200 NTC probe, 10k, 1 %, B 3977, stainless cap 3 x 12 mm, 200 mm PTFE leads | B0D72WYT8Z | 1 | 8BitDo Ultimate 2C Wired controller (PC/Android): Hall effect sticks and triggers, 1000 Hz, USB | 696832262161 | 1 | Pimoroni HyperPixel 4.0 display, 800 x 480, touchscreen (PIM369)
732-2096-ND | 10 | Würth 61202021621 WR-BHD box header, 2x10, 2.54 mm, shrouded, straight, through-hole | B09NDP48TX | 1 | VooGenzek PCB prototyping kit: 20 perfboards, 2/3-pin screw terminals, male and female pin headers | 31597425033278 | 1 | Raspberry Pi Micro-HDMI to HDMI cable, 2 m, black (SC0532)
P14454-ND | 20 | Panasonic EEU-FR1H101 electrolytic capacitor, 100 uF 50 V, low ESR, radial 8 x 11.5 mm, 3.5 mm pitch | B01GY36RJY | 1 | GLARKS 2.54 mm pin header kit, 40 pcs in 8 kinds: 1x40 and 2x40 male, straight and right-angle; 1x40 and 2x40 female; round-pin male and female | 42183571833027 | 1 | Polyimide (Kapton) tape, 15 mm x ~33 m, amber, single-sided
1N5819HW-FDICT-ND | 10 | Diodes Inc 1N5819HW-7-F Schottky diode, SOD-123, 1 A 40 V | B07G732HNX | 1 | TUOFENG 26 AWG silicone wire, 6 colours x 10 m | 37627618066627 | 3 | Teensy 4.1 with Ethernet, pre-assembled headers (PJRC DEV-16996)
CP-063AH-ND | 10 | Same Sky (CUI) PJ-063AH barrel jack, 5.5 mm, 2.0 mm pin, 8 A, 24 V DC, PCB horizontal | B092VWZN4W | 1 | Heat-shrink tubing assortment, 2:1, 560 pcs | 37627737669827 | 3 | PJRC Ethernet Kit for Teensy 4.1: MagJack, bare adaptor board, 6-wire cable, two 2x3 2 mm headers, capacitor
CP3-002AH-ND | 10 | Same Sky (CUI) PP3-002AH DC plug, 5.5 x 2.1 mm, 14 mm barrel, solder eyelets, screw-on cover | B0F38BVTWW | 1 | 900Pcs Bolts and Nuts Set,M2 M2.5 M3
1866-3346-ND | 1 | Mean Well LRS-350-24 power supply, 24 V 14.6 A, 350 W, enclosed | B0CNR3XJM9 | 1 | M3-0.5x6mm Button Head Socket Cap Screws
1939-1673-ND | 1 | GlobTek 6104136F000 mains lead, UK plug (BS1363) to bare cable, H05RN-F, 17 AWG, 1.86 m, black | B072SLJR2T | 1 | Gocableties cable ties, 100 x 2.5 mm, pack of 100
455-1724-ND | 10 | JST S7B-PH-K-S header, PH 7-pin, 2.0 mm, side entry, through-hole | B0FH28CQ2Q | 1 | 1DFAUL conformal coating for electronics, 200 ml
455-S3B-PH-SM4-TBCT-ND | 10 | JST S3B-PH-SM4-TB header, PH 3-pin, 2.0 mm, side entry, SMD | B0CFFDWMWZ | 1 | USB-C PD charger plug, 20 W, UK, 3-pack
455-S4B-ZR-SM4A-TFCT-ND | 10 | JST S4B-ZR-SM4A-TF header, ZH 4-pin, 1.5 mm, side entry, SMD | B0F8BJ1MX4 | 1 | Araldite Standard 2-part epoxy, slow cure, 2 x 15 ml tubes (ARA-400001)
455-1161-ND | 10 | JST PHR-7 housing, PH 7-pin, 2.0 mm | B000XBH9HI | 1 | Synthetic grease
455-1126-ND | 10 | JST PHR-3 housing, PH 3-pin, 2.0 mm | B0FD2XSKKP | 3 | M4 x 8 mm countersunk bolts, pack of 20
455-3083-ND | 30 | JST ASPHSPH24K305 pre-crimped PH lead, 24 AWG, 305 mm, socket both ends | B0FD316BX3 | 3 | M4 x 10 mm countersunk bolts, pack of 20
455-1202-ND | 10 | JST ZHR-4 housing, ZH 4-pin, 1.5 mm | B0FKMPXRCS | 10 | INJORA INJS11 11 kg coreless digital micro servo (INJS11GD)
455-3080-ND | 20 | JST ASZHSZH28K305 pre-crimped ZH lead, 28 AWG, 305 mm, socket both ends | B0GHLXD2JL | 1 | Stainless steel balls, 6 mm, G25, 120 pcs
M3AAA-2018J-ND | 5 | 3M M3AAA-2018J IDC cable, 20-way, socket to socket, 457 mm (18 in) | B003MWC1CS | 1 | Neodymium disc magnet, 6 x 2 mm, N42, 20 pcs
108-SK-12D07-VG4NSPA-ND | 30 | C&K SK-12D07-VG 4 NS PA slide switch, SPDT, right angle, through-hole, 2.0 mm pitch, 4 mm handle | B015UQKQQG | 1 | Neodymium disc magnet, 6 x 3 mm, N42, 20 pcs
 |  |  | B0998KCDHK | 5 | BQLZR TES1-4902 Peltier module, 20 x 20 x 4 mm, 6 V 2 A, pack of 2
 |  |  | B098JTRFQ6 | 2 | TES1-4902 Peltier module, 20 x 20 mm, 6 V 2 A (second supplier)
 |  |  | B07LF66ZSV | 1 | ARCTIC MX-4 thermal paste, 8 g
 |  |  | B001W03PH2 | 1 | Rust-Oleum Painter's Touch spray paint, matt black, 400 ml
 |  |  | B08Y6YR45F | 3 | Linear stage with NEMA11 stepper, 150 mm stroke, T6x1 lead screw, MGN9 rail
 |  |  | B0FC2N8718 | 1 | Ultra-slim Cat6 Ethernet cable, 2.8 mm OD, 3 m, 6-pack
 |  |  | B097TBKXZL | 1 | KEXIN 16 GB microSDHC card, Class 10 UHS-I, 5-pack, with SD adapter
 |  |  | B07TT52X28 | 1 | Haerkn 22 AWG silicone 2-core cable, 10 m
 |  |  | B0DM5ZPQFH | 1 | sourcing map silicone solid cord, 2 mm, 10m
