asrvsn/mmi/hardware/frame/drive_pcb/jlc/drive_bom_jlc.csv

Comment | Designator | Footprint | LCSC Part #
22u 25V | C1,C16,C22,C23,C24,C25,C71,C72,C73,C74,C75,C76 | C_1206_3216Metric | C12891
10n 50V | C9,C10,C11,C21,C78 | C_0603_1608Metric | C57112
10u 50V | C18,C53,C79,C80 | C_1206_3216Metric | C13585
100n 50V / 100n | C19,C56 | C_0603_1608Metric | C14663
2n2 50V | C26 | C_0603_1608Metric | C1604
68n 50V | C27 | C_0603_1608Metric | C31658
100p 50V | C28 | C_0603_1608Metric | C14858
100n 50V | C44,C45,C46 | C_0402_1005Metric | C307331
1u 50V | C77 | C_0603_1608Metric | C15849
SS34 | D4 | D_SMA | C8678
SMAJ12A | D6 | D_SMA | C19077531
SMAJ24A | D15 | D_SMA | C19077541
22u 4.4A | L1 | L_Sunlord_MWSA1004S | C408489
HL2309 | Q3 | SOT-23 | C28646263
2N7002 | Q5 | SOT-23 | C8545
13k | R33 | R_0603_1608Metric | C22797
2k | R34,R42,R43,R44 | R_0603_1608Metric | C22975
820 | R35 | R_0603_1608Metric | C23253
100k | R36,R78 | R_0603_1608Metric | C25803
10k | R58 | R_0603_1608Metric | C25804
4k7 | R59 | R_0603_1608Metric | C23162
150k | R79 | R_0603_1608Metric | C22807
1k | R80 | R_0603_1608Metric | C21190
TPS5430DDA | U3 | TI_SO-PowerPAD-8_ThermalVias | C9864
DRV8251ADDA | U4,U8,U9 | Texas_HTSOP-8-1EP_3.9x4.9mm_P1.27mm_EP2.95x4.9mm_Mask2.4x3.1mm_ThermalVias | C5218844
