asrvsn/mmi/hardware/frame/main_pcb/jlc/main_bom_jlc.csv

Comment | Designator | Footprint | LCSC Part #
100n 50V | C2,C17,C30,C36,C39,C82 | C_0402_1005Metric | C307331
100n | C4,C5,C6,C7,C8,C13,C14,C15,C42,C43,C83 | C_0402_1005Metric | C1525
470n 25V | C20,C50,C51,C52 | C_0603_1608Metric | C1623
10u 50V | C29,C38 | C_1206_3216Metric | C13585
10n 50V | C31,C47,C48,C49 | C_0402_1005Metric | C15195
22u 25V | C32,C33,C34 | C_1206_3216Metric | C12891
1n 50V | C35 | C_0402_1005Metric | C1523
100p 50V | C37 | C_0402_1005Metric | C1546
22n 50V | C40 | C_0402_1005Metric | C1532
4u7 16V | C41 | C_0603_1608Metric | C19666
2u2 50V | C54 | C_0805_2012Metric | C377773
47n 50V | C55 | C_0603_1608Metric | C1622
1n 2kV | C67 | C_1206_3216Metric | C9196
1u 50V | C81 | C_0603_1608Metric | C15849
SMBJ24CA | D3 | D_SMB | C19077579
SS34 | D5 | D_SMA | C8678
BZT52C12 | D7 | D_SOD-123 | C19077410
XL-3210UGC | D8 | LED_SideView_XL-3210 | C965877
XL-3210RGBC-YG | D9 | LED_RGB_SideView_XL-3210RGBC | C965884
B5819W | D10 | D_SOD-123 | C8598
XL-3210SURC | D11 | LED_SideView_XL-3210 | C965874
SMF05CT1G | D13 | SOT-363_SC-70-6 | C15879
XL-3210UYC | D16 | LED_SideView_XL-3210 | C965876
PTC 1.1 A 33 V | F1,F2,F3,F4 | Fuse_1812_4532Metric | C142747
PTC 0.5 A 30 V | F5,F6 | Fuse_1812_4532Metric | C151168
22u 2.05A | L2 | L_Sunlord_SWPA6045S | C83454
HL2310A | Q1,Q2 | SOT-23 | C7420347
AO4485 | Q4,Q6,Q8 | SOIC-8_3.9x4.9mm_P1.27mm | C51499
1k | R1,R4,R6,R8,R10,R12,R15,R16,R19,R20,R60,R61,R62,R63,R64,R65,R67,R72,R77,R84,R88 | R_0402_1005Metric | C11702
10k | R2,R25,R28,R45,R46,R47,R48,R50 | R_0402_1005Metric | C25744
2k | R3,R5,R7,R9,R11 | R_0402_1005Metric | C4109
49.9 | R13,R14 | R_0805_2012Metric | C17720
1M | R17,R18,R56 | R_0402_1005Metric | C26083
100k | R21,R22,R55,R82,R86 | R_0402_1005Metric | C25741
15k | R26,R49 | R_0402_1005Metric | C25756
100 | R29,R30,R31,R32 | R_0402_1005Metric | C25076
12k | R37 | R_0402_1005Metric | C25752
3k9 | R38 | R_0603_1608Metric | C23018
470 | R39,R68,R69 | R_0402_1005Metric | C25117
1R 0805 | R40,R41,R51,R52,R53,R54 | R_0805_2012Metric | C25271
470k | R57 | R_0603_1608Metric | C23178
2k2 | R66,R73,R74 | R_0402_1005Metric | C25879
1M | R76 | R_1206_3216Metric | C17927
22k | R81,R85 | R_0402_1005Metric | C25768
150k | R83 | R_0603_1608Metric | C22807
13k | R87 | R_0603_1608Metric | C22797
TMC2209-LA | U2 | VQFN-28-1EP_5x5mm_P0.5mm_EP3.7x3.7mm | C2150710
TPS5430DDA | U5 | TI_SO-PowerPAD-8_ThermalVias | C9864
MCP6002T-I/SN | U7 | SOIC-8_3.9x4.9mm_P1.27mm | C7377
