asrvsn/mmi/hardware/lid/heating_pcb/jlc/heating_bom_jlc.csv

Comment | Designator | Footprint | LCSC Part #
1u 25V | C1 | C_0402_1005Metric | C52923
10u 50V | C2,C16,C25,C26 | C_1206_3216Metric | C13585
22u 25V | C3,C4,C6,C22 | C_1206_3216Metric | C12891
100n 50V | C5,C17,C20 | C_0402_1005Metric | C307331
100n 50V | C7,C8 | C_1206_3216Metric | C24497
100n | C9,C10,C11,C12,C13,C14,C15 | C_0402_1005Metric | C1525
10n 50V | C18 | C_0402_1005Metric | C15195
1n 50V | C19 | C_0402_1005Metric | C1523
100p 50V | C21 | C_0402_1005Metric | C1546
1u 50V | C23 | C_0603_1608Metric | C15849
10n 50V | C24 | C_0603_1608Metric | C57112
SMAJ24A | D1 | D_SMA | C19077541
SMF05CT1G | D2 | SOT-363_SC-70-6 | C15879
SS34 | D3 | D_SMA | C8678
0 | JP1 | R_0603_1608Metric_Jumper | C21189
0 | JP2,JP3,JP4 | R_1206_3216Metric_Jumper | C17888
22u 1.4A | L1 | L_Sunlord_SWPA6028S | C51349
HL2309 | Q1 | SOT-23 | C28646263
100k | R1,R2,R12,R14 | R_0402_1005Metric | C25741
51k | R3 | R_0402_1005Metric | C25794
10k | R6,R7,R8,R9,R10,R13,R15 | R_0402_1005Metric | C25744
1k | R16 | R_1206_3216Metric | C4410
1 | R17 | R_1206_3216Metric | C17928
13k | R18 | R_0603_1608Metric | C22797
2k | R19 | R_0402_1005Metric | C4109
470 | R20 | R_0402_1005Metric | C25117
100k | R21 | R_0603_1608Metric | C25803
150k | R22 | R_0603_1608Metric | C22807
1k | R23 | R_0603_1608Metric | C21190
100 | R25,R27,R28 | R_0603_1608Metric | C22775
100 | R26 | R_1206_3216Metric | C17901
10k B3435 1% | RT1,RT2,RT3 | R_0603_1608Metric | C13564
SC72AAB | TCO1 | Bourns_SC_TCO | C2859510
HT7533-1 | U1 | SOT-89-3 | C14289
DRV8871DDA | U2 | Texas_HTSOP-8-1EP_3.9x4.9mm_P1.27mm_EP2.95x4.9mm_NoVias | C75864
ADS1115 | U3,U4 | TSSOP-10_3x3mm_P0.5mm | C37593
TPS5430DDA | U5 | TI_SO-PowerPAD-8 | C9864
