asrvsn/mmi/hardware/frame/main_pcb/main.step

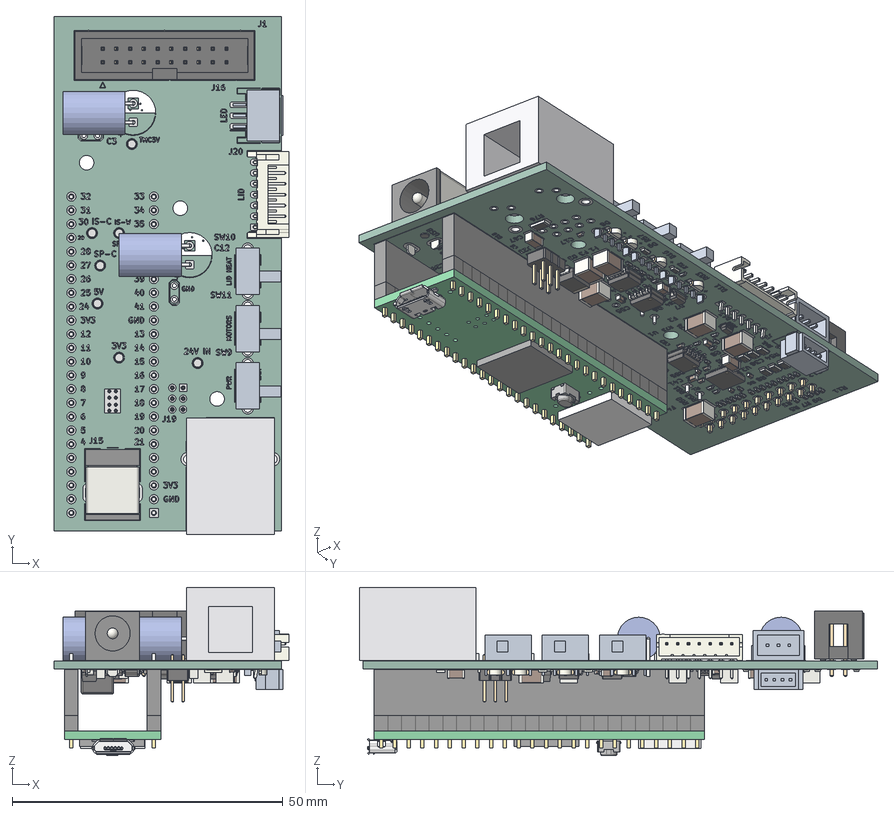
[picture p56: CAD file, 2026-11-12]
hardware/frame/main_pcb/main.step
43.4 x 95.7 x 31.1 mm
can x 2
leads x 2
C&K SK-12D07-VG 4 NS PA 1 x 3
C&K SK-12D07-VG 4 NS PA 2 x 3
JST_S3B-PH-SM4-TB_1
JST_S3B-PH-SM4-TB_pins
JST_S3B-PH-SM4-TB_2
JST_S3B-PH-SM4-TB_3
IDC_Header_2x10_P254mm_Vertical
BarrelJack_CUI_PJ-063AH_Horizontal
MagJack
JST_S7B_PH_K
R_0402_1005Metric x 57
C_0402_1005Metric x 24
C_1812_4532Metric x 6
C_0603_1608Metric x 7
SOIC-8_3.9x4.9mm_P1.27mm x 4
R_1206_3216Metric
R_0805_2012Metric x 8
JST_S4B-ZR-SM4A-TF_1
JST_S4B-ZR-SM4A-TF_pins
JST_S4B-ZR-SM4A-TF_2
JST_S4B-ZR-SM4A-TF_3
LED_XINGLIGHT_1204_3210Metric_SideView x 4
C_0805_2012Metric
D_SMA
SOT-363_SC-70-6
PinHeader_2x03_P200mm_Vertical
R_0603_1608Metric x 4
C_1206_3216Metric x 6
D_SOD-123 x 2
SOT-23 x 2
sockets
socket_tails
pcb
header_plastic
header_pins
mcu
usb
microsd
button
D_SMB
QFN-28-1EP_5x5mm_Pitch0.5mm
TI_SO-PowerPAD-8
a6c163e6-8551-11ed-a139-00155d22e2d7_part
a6c16512-8551-11ed-a139-00155d22e2d7_part
a6c16594-8551-11ed-a139-00155d22e2d7_part
main_pad
main_silkscreen x 2
main_PCB
