asrvsn/mmi/hardware/frame/parts/main_enclosure_cap.step

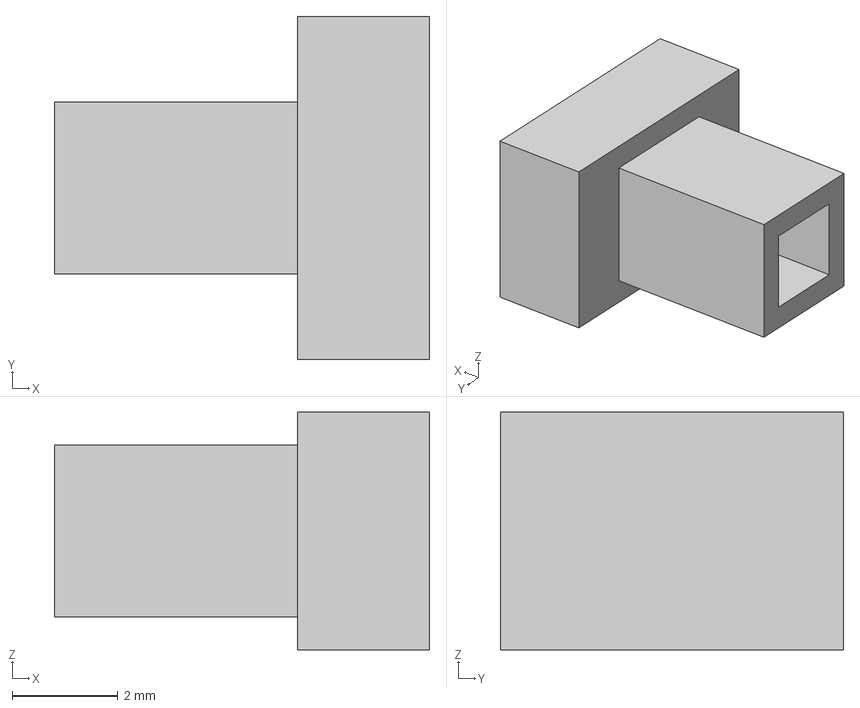
[picture p57: CAD file, 2026-11-12]
hardware/frame/parts/main_enclosure_cap.step
7.10 x 6.50 x 4.50 mm
