asrvsn/mmi/hardware/frame/parts/main_enclosure_tray.step

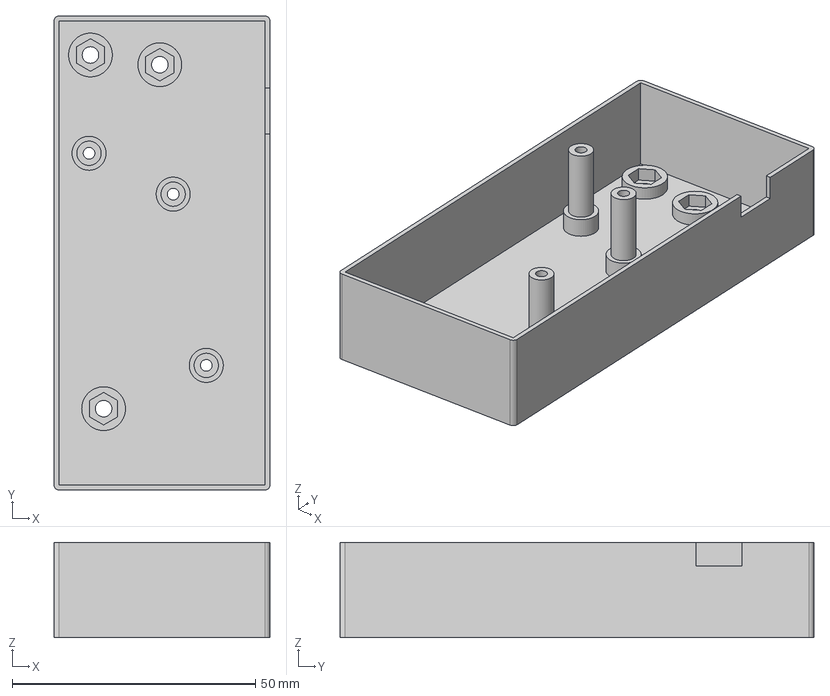
[picture p58: CAD file, 2026-11-12]
hardware/frame/parts/main_enclosure_tray.step
44.4 x 97.4 x 19.6 mm
