asrvsn/mmi/hardware/frame/parts/main_enclosure_cover.step

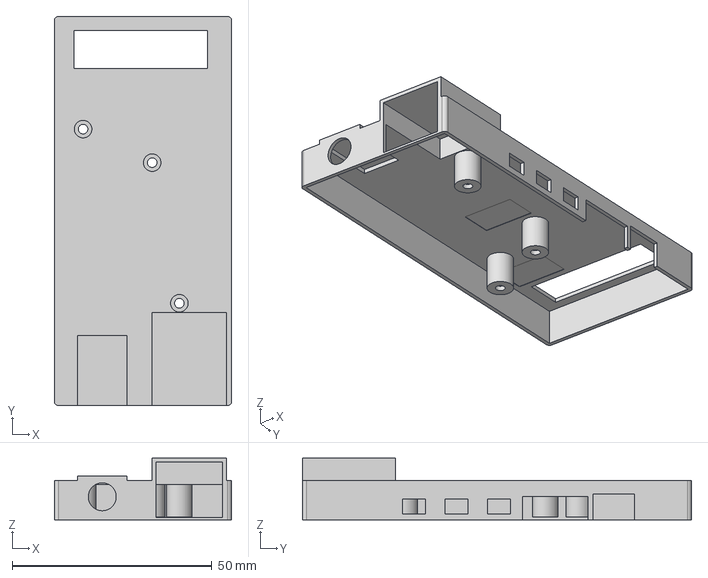
[picture p59: CAD file, 2026-11-12]
hardware/frame/parts/main_enclosure_cover.step
44.4 x 97.4 x 15.5 mm
