asrvsn/mmi/hardware/capillary_mounts/parts/end_effector_base.step

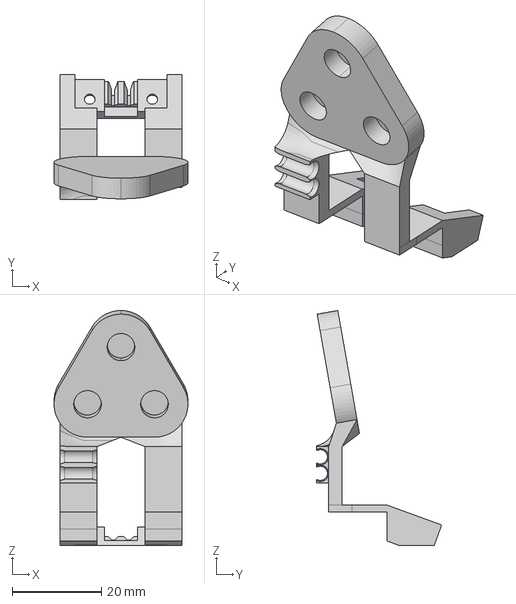
[picture p60: CAD file, 2026-11-12]
hardware/capillary_mounts/parts/end_effector_base.step
30.0 x 28.1 x 52.6 mm
