asrvsn/mmi/hardware/frame/drive_pcb/drive.step

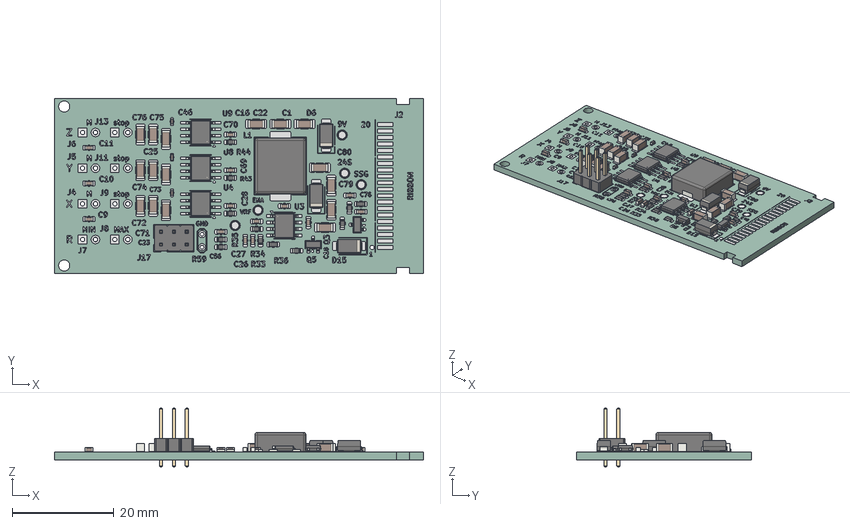
[picture p61: CAD file, 2026-11-12]
hardware/frame/drive_pcb/drive.step
72.4 x 34.4 x 11.5 mm
C_0603_1608Metric x 14
R_0603_1608Metric x 12
SOT-23 x 2
TI_SO-PowerPAD-8
C_1206_3216Metric x 16
a74a438c-8551-11ed-a139-00155d22e2d7_part
a74a44b8-8551-11ed-a139-00155d22e2d7_part
a74a453a-8551-11ed-a139-00155d22e2d7_part
Texas_HTSOP_8_1EP_39x49mm_P127mm_EP285x49mm_Mask24x31mm_ThermalVias x 3
D_SMA x 3
C_0402_1005Metric x 3
PinHeader_2x03_P254mm_Vertical
drive_pad
drive_silkscreen
drive_PCB
