asrvsn/mmi/hardware/frame/parts/gear30_bore_ID13.15.step

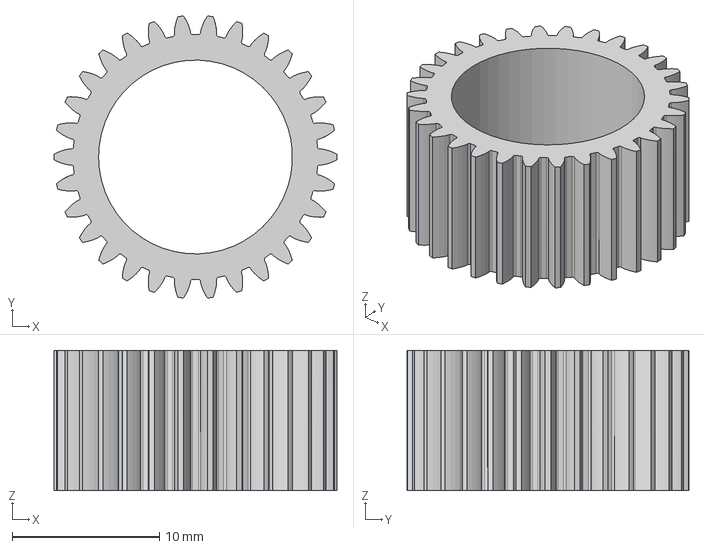
[picture p62: CAD file, 2026-11-12]
hardware/frame/parts/gear30_bore_ID13.15.step
19.2 x 19.1 x 9.50 mm
