asrvsn/mmi/hardware/insert/parts/insert.step

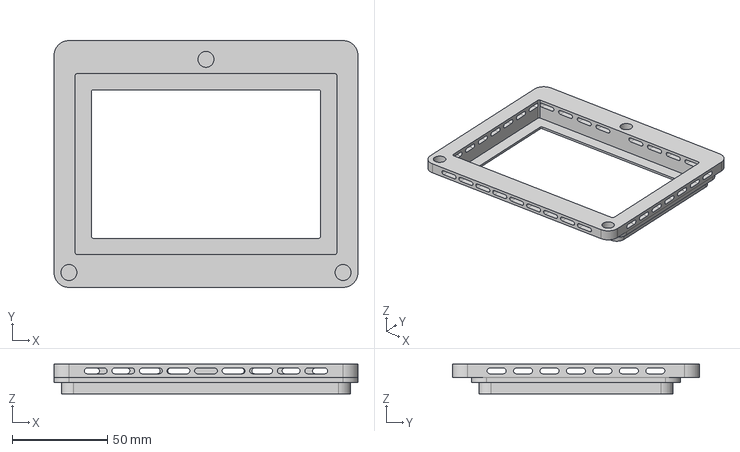
[picture p63: CAD file, 2026-11-12]
hardware/insert/parts/insert.step
159.7 x 129.7 x 15.5 mm
