asrvsn/mmi/hardware/lid/heating_pcb/heating.step

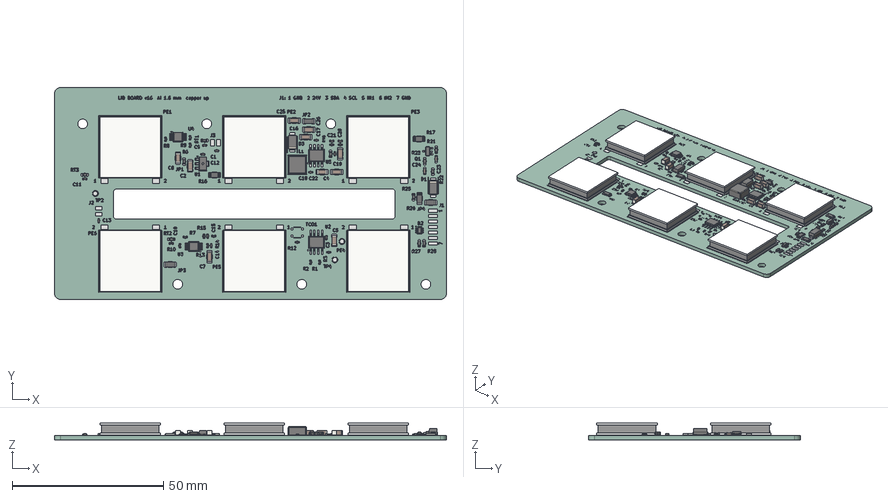
[picture p64: CAD file, 2026-11-12]
hardware/lid/heating_pcb/heating.step
129.5 x 70.0 x 5.59 mm
R_0402_1005Metric x 14
R_1206_3216Metric x 6
D_SMA x 2
C_0402_1005Metric x 14
C_0603_1608Metric x 2
TSSOP-10_3x3mm_P0.5mm x 2
R_0603_1608Metric x 11
C_1206_3216Metric x 10
adbeea57-9c39-11ed-93f0-dde97e994e83_part
adbeea58-9c39-11ed-93f0-dde97e994e83_part
adbeea59-9c39-11ed-93f0-dde97e994e83_part
thermoelements x 6
Texas_HTSOP_8_1EP_39x49mm_P127mm_EP285x49mm_Mask24x31mm_ThermalVias
SOT-363_SC-70-6
a6af931e-8551-11ed-a139-00155d22e2d7_part
a6af945e-8551-11ed-a139-00155d22e2d7_part
a6af94ea-8551-11ed-a139-00155d22e2d7_part
TI_SO-PowerPAD-8
SOT-23
heating_pad
heating_silkscreen
heating_PCB
