asrvsn/mmi/hardware/lid/parts/lid_frame.step

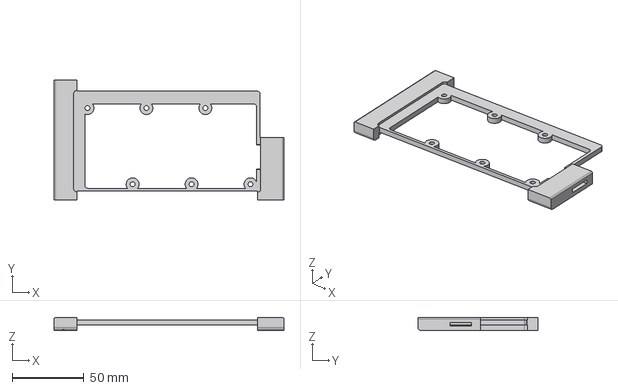
[picture p65: CAD file, 2026-11-12]
hardware/lid/parts/lid_frame.step
160.0 x 83.6 x 8.92 mm
