asrvsn/mmi/hardware/lid/plate_pcb/plate.step

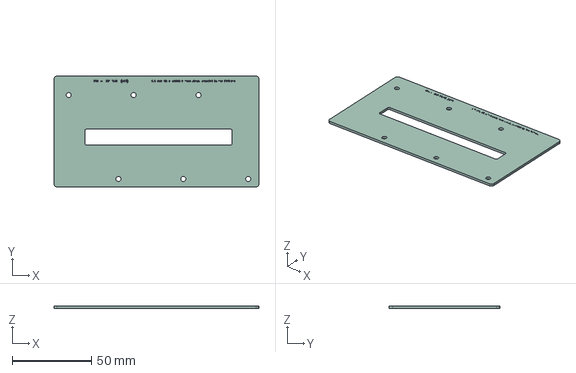
[picture p66: CAD file, 2026-11-12]
hardware/lid/plate_pcb/plate.step
129.5 x 70.0 x 1.59 mm
plate_silkscreen
plate_PCB
