asrvsn/mmi/hardware/capillary_mounts/parts/face_plate.step

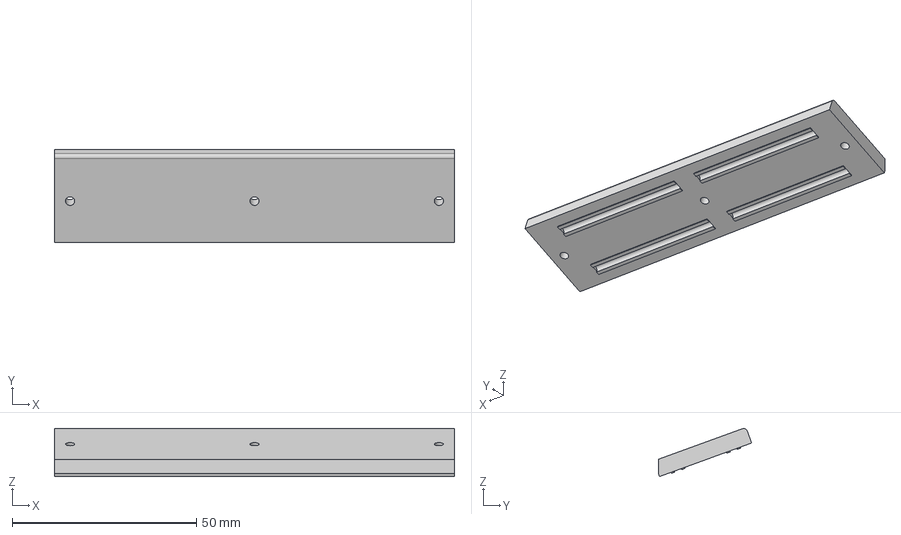
[picture p67: CAD file, 2026-11-12]
hardware/capillary_mounts/parts/face_plate.step
108.5 x 25.3 x 13.1 mm
