asrvsn/mmi/hardware/frame/parts/gear16_D-0.05.step

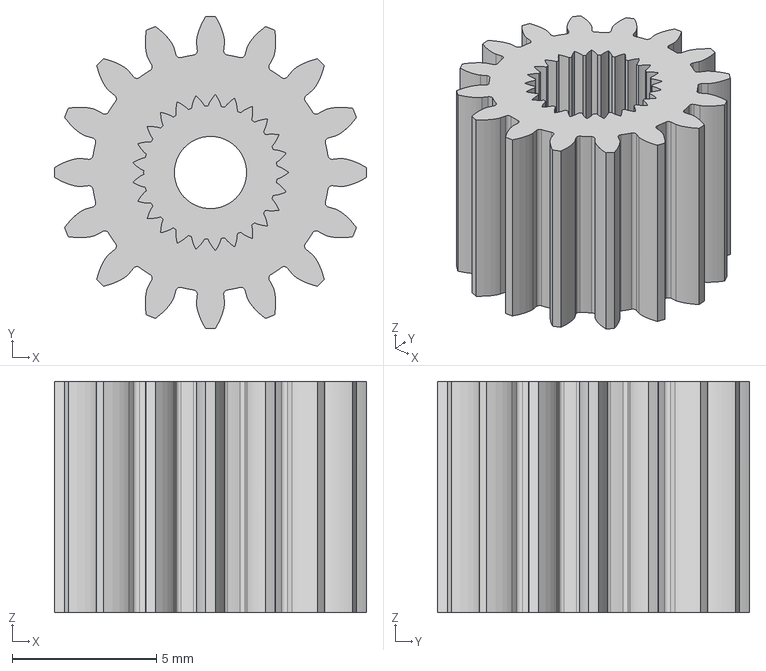
[picture p68: CAD file, 2026-11-12]
hardware/frame/parts/gear16_D-0.05.step
10.8 x 10.8 x 8.00 mm
