asrvsn/mmi/hardware/capillary_mounts/parts/end_effector_clamp.step

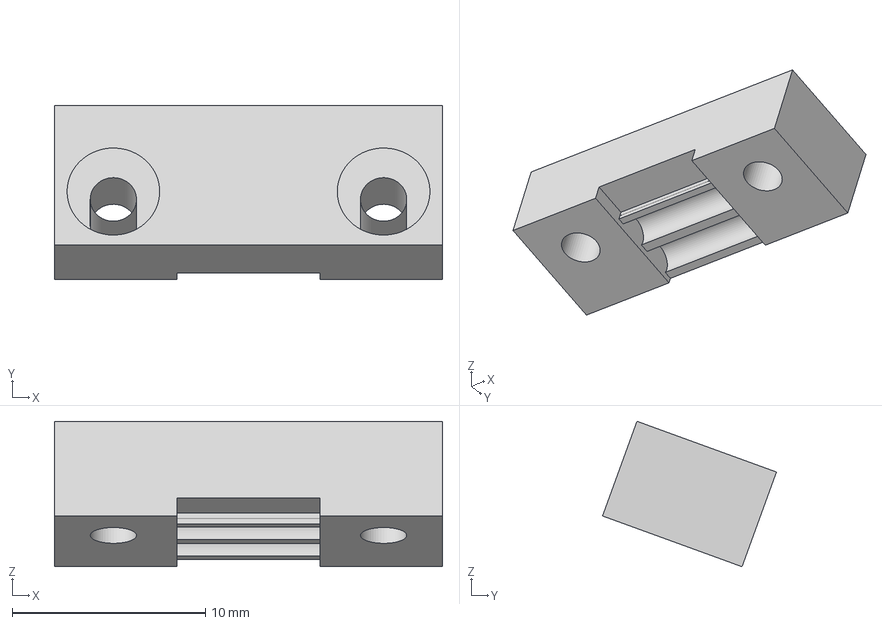
[picture p69: CAD file, 2026-11-12]
hardware/capillary_mounts/parts/end_effector_clamp.step
20.1 x 9.01 x 7.53 mm
