asrvsn/mmi/hardware/frame/parts/motor_enclosure_front_cover.step

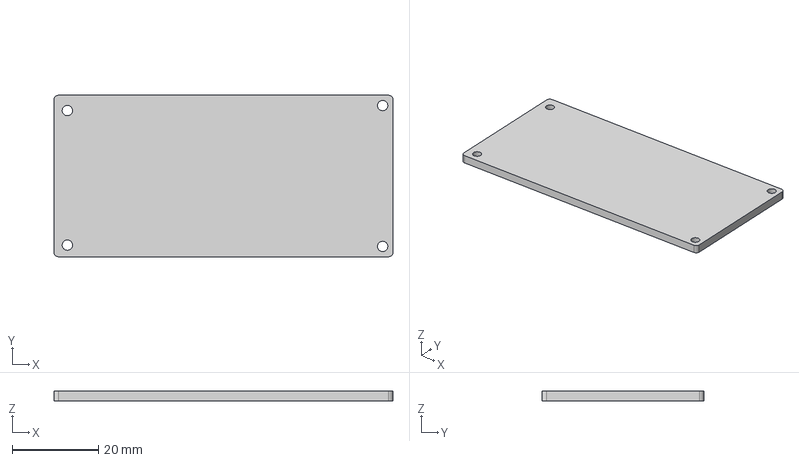
[picture p70: CAD file, 2026-11-12]
hardware/frame/parts/motor_enclosure_front_cover.step
78.6 x 37.5 x 2.21 mm
