asrvsn/mmi/hardware/capillary_mounts/parts/capillaries_mount.step

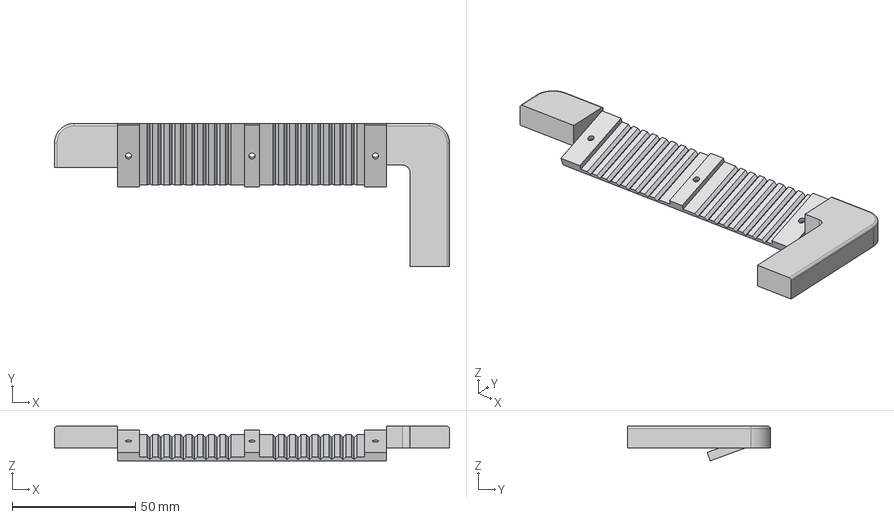
[picture p71: CAD file, 2026-11-12]
hardware/capillary_mounts/parts/capillaries_mount.step
160.0 x 58.0 x 14.0 mm
