asrvsn/mmi/hardware/frame/parts/y_brace.step

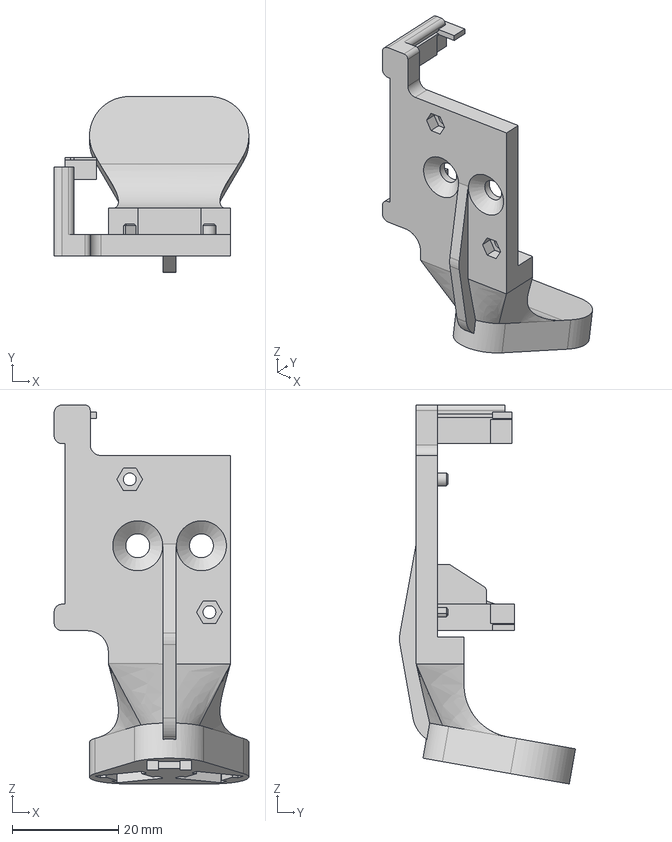
[picture p72: CAD file, 2026-11-12]
hardware/frame/parts/y_brace.step
36.7 x 33.1 x 71.3 mm
