asrvsn/mmi/hardware/frame/parts/x_brace.step

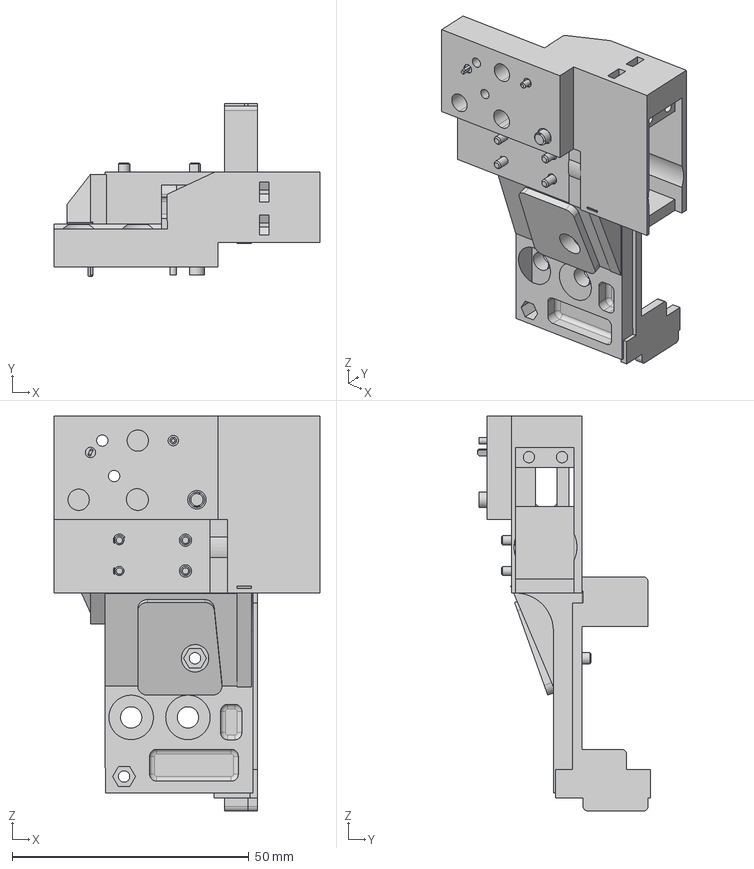
[picture p73: CAD file, 2026-11-12]
hardware/frame/parts/x_brace.step
56.2 x 36.5 x 83.5 mm
