asrvsn/mmi/hardware/frame/parts/z_brace.step

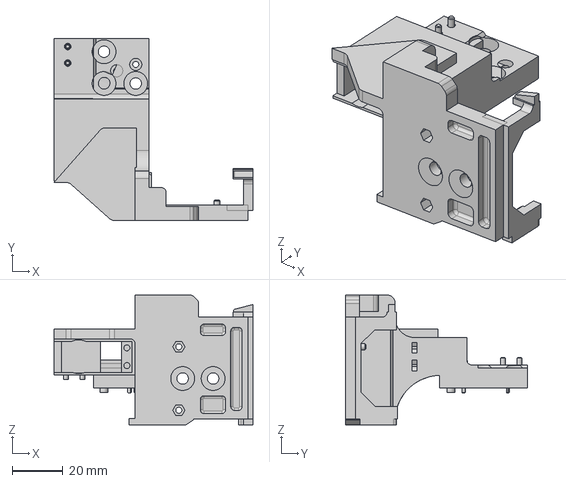
[picture p74: CAD file, 2026-11-12]
hardware/frame/parts/z_brace.step
78.4 x 71.7 x 51.2 mm
