asrvsn/mmi/hardware/frame/parts/motor_enclosure_back_plate.step

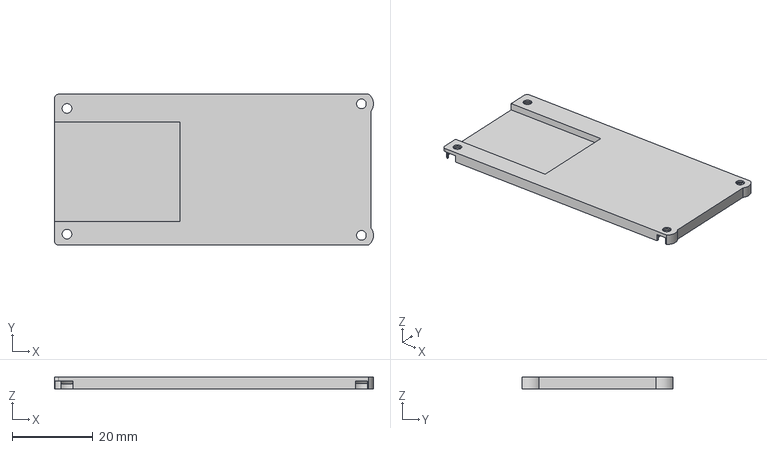
[picture p75: CAD file, 2026-11-12]
hardware/frame/parts/motor_enclosure_back_plate.step
79.2 x 37.5 x 3.00 mm
