asrvsn/mmi/hardware/frame/parts/x_face.step

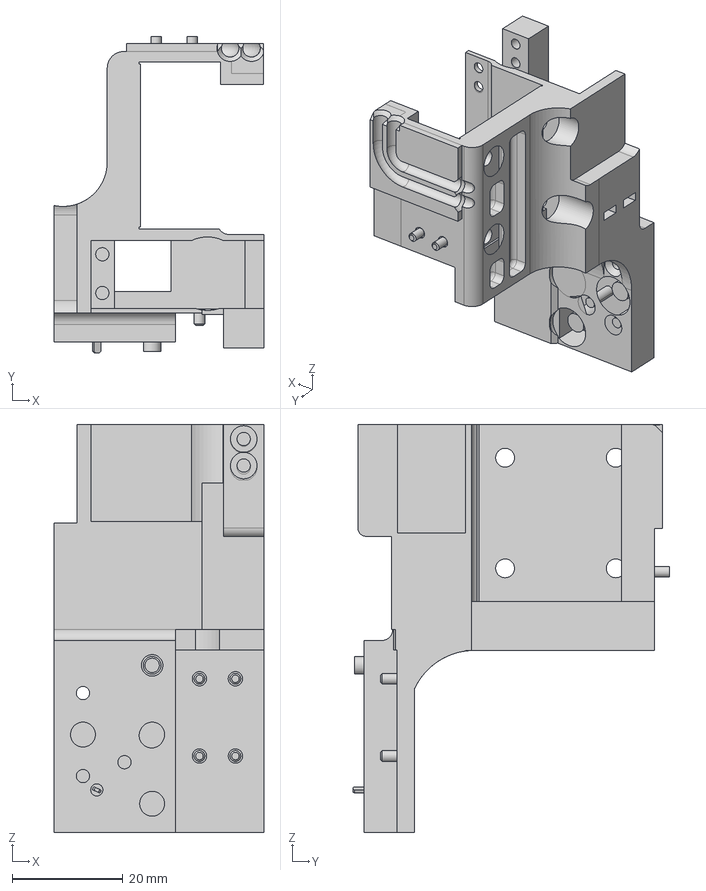
[picture p76: CAD file, 2026-11-12]
hardware/frame/parts/x_face.step
37.9 x 57.5 x 73.7 mm
