asrvsn/mmi/hardware/frame/parts/frame.step

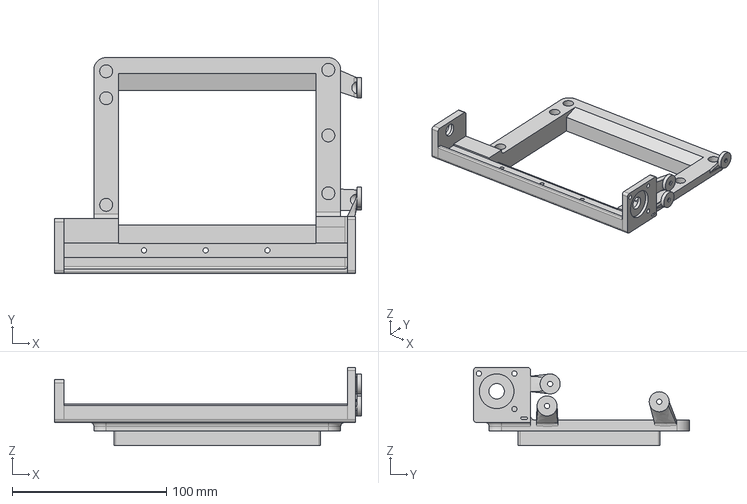
[picture p77: CAD file, 2026-11-12]
hardware/frame/parts/frame.step
199.0 x 140.0 x 50.8 mm
