asrvsn/mmi/hardware/frame/parts/motor_board_arm.step

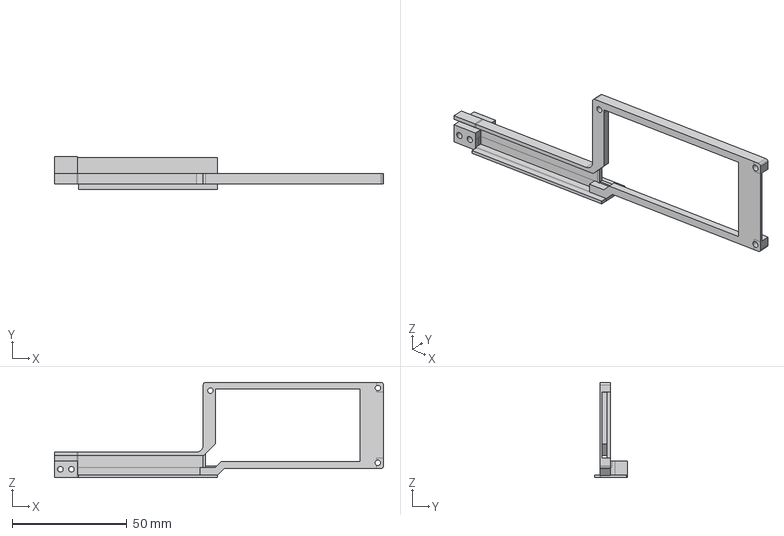
[picture p78: CAD file, 2026-11-12]
hardware/frame/parts/motor_board_arm.step
143.6 x 14.6 x 41.6 mm
