asrvsn/mmi/(list of files, cad)

Other CAD files:
mmi.f3d
