asrvsn/mmi/hardware/frame/drive_pcb/drive.kicad_pcb

## KiCad design hardware/frame/drive_pcb/drive.kicad_pcb (2026-11-12)

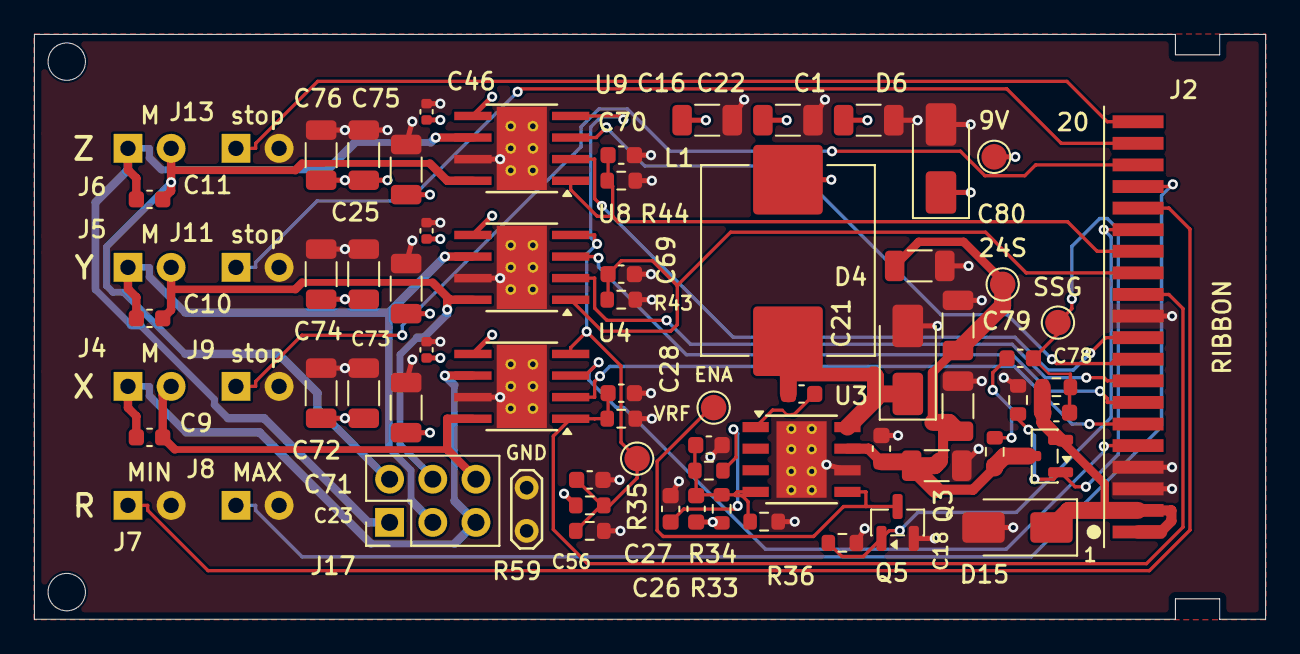
[picture p89: board drive.kicad_pcb from above]

Board: 4 copper layers, 72.4 x 34.4 mm, 73 parts (0 on the bottom side), 33 nets.

Parts:
C1, C16, C22, C23, C24, C25, C71, C72, C73, C74, C75, C76: 22u 25V; C_1206_3216Metric
C9, C10, C11, C21, C68, C69, C70, C78: 10n 50V; C_0603_1608Metric
C18, C53, C79, C80: 10u 50V; C_1206_3216Metric
C19: 100n 50V; C_0603_1608Metric
C26: 2n2 50V; C_0603_1608Metric
C27: 68n 50V; C_0603_1608Metric
C28: 100p 50V; C_0603_1608Metric
C44, C45, C46: 100n 50V; C_0402_1005Metric
C56: 100n; C_0603_1608Metric
C77: 1u 50V; C_0603_1608Metric
D4: SS34; D_SMA
D6: SMAJ12A; D_SMA
D15: SMAJ24A; D_SMA
J2: Ribbon pads (20 x 1.27 mm); SolderPads_1x20_P1.27mm_Ribbon_Pad1Bottom
J4: X motor; WireHoles_1x02_P2.54mm_D0.9mm
J5: Y motor; WireHoles_1x02_P2.54mm_D0.9mm
J6: Z motor; WireHoles_1x02_P2.54mm_D0.9mm
J7: rail MIN (home); WireHoles_1x02_P2.54mm_D0.9mm
J8: rail MAX; WireHoles_1x02_P2.54mm_D0.9mm
J9: X stops; WireHoles_1x02_P2.54mm_D0.9mm
J11: Y stops; WireHoles_1x02_P2.54mm_D0.9mm
J13: Z stops; WireHoles_1x02_P2.54mm_D0.9mm
J17: Motors (test); PinHeader_2x03_P2.54mm_Vertical
L1: 22u 4.4A; L_Sunlord_MWSA1004S
MH1, MH2: M2; MountingHole_2.2mm_M2
Q3: HL2309; SOT-23
Q5: 2N7002; SOT-23
R33: 13k; R_0603_1608Metric
R34, R42, R43, R44: 2k; R_0603_1608Metric
R35: 820; R_0603_1608Metric
R36, R78: 100k; R_0603_1608Metric
R58: 10k; R_0603_1608Metric
R59: 4k7; R_0603_1608Metric
R79: 150k; R_0603_1608Metric
R80: 1k; R_0603_1608Metric
TP11: 24S; TestPoint_Pad_D1.5mm
TP12: SSG; TestPoint_Pad_D1.5mm
TP13: 9V; TestPoint_Pad_D1.5mm
TP14: VRF; TestPoint_Pad_D1.5mm
TP15: ENA; TestPoint_Pad_D1.5mm
TP16: GND; TestPoint_2Pads_Pitch2.54mm_Drill0.8mm
U3: TPS5430DDA; TI_SO-PowerPAD-8_ThermalVias
U4, U8, U9: DRV8251ADDA; Texas_HTSOP-8-1EP_3.9x4.9mm_P1.27mm_EP2.95x4.9mm_Mask2.4x3.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

Connections:
+9V: C1.1, C16.1, C22.1, C23.1, C24.1, C25.1, C26.1, C44.1, C45.1, C46.1, C71.1, C72.1, C73.1, C74.1, C75.1, C76.1, D6.1, L1.2, R33.1, R58.1, TP13.1, U4.5, U8.5, U9.5
/BOOT9: C21.2, U3.1
/ENA9: Q5.3, TP15.1, U3.5
/FB9: C26.2, C28.1, R33.2, R34.1, R35.1, U3.4
/HEAD_24V: C77.1, D15.1, J2.1, J2.2, Q3.2, R78.1
/HEAD_24V_SS: C18.1, C19.1, C53.1, C79.1, C80.1, Q3.3, R80.1, TP11.1, U3.7
/MX_A: C9.1, J4.1, J17.5, U4.6
/MX_B: C9.2, J4.2, J17.6, U4.8
/MX_IN1_C: J2.5, U4.3
/MX_IN2_C: J2.6, U4.2
/MX_IP: C68.1, J2.12, R42.1, U4.1
/MY_A: C10.1, J5.1, J17.3, U8.6
/MY_B: C10.2, J5.2, J17.4, U8.8
/MY_IN1_C: J2.7, U8.3
/MY_IN2_C: J2.8, U8.2
/MY_IP: C69.1, J2.13, R43.1, U8.1
/MZ_A: C11.1, J6.1, J17.1, U9.6
/MZ_B: C11.2, J6.2, J17.2, U9.8
/MZ_IN1_C: J2.9, U9.3
/MZ_IN2_C: J2.10, U9.2
/MZ_IP: C70.1, J2.14, R44.1, U9.1
/PH_9V: C21.1, D4.1, L1.1, U3.8
/SS_G: C77.2, C78.2, Q3.1, R78.2, R79.1, TP12.1
/SS_M: C78.1, R80.2
/SW_MAX: J2.17, J8.1
/SW_MIN: J2.16, J7.1
/SW_X: J2.18, J9.1
/SW_Y: J2.19, J11.1
/SW_Z: J2.20, J13.1
/V9_OFF_C: J2.15, Q5.1, R36.1
/VREF_H: C56.1, R58.2, R59.1, TP14.1, U4.4, U8.4, U9.4
/ZC9: C27.1, R35.2
GND: C1.2, C16.2, C18.2, C19.2, C22.2, C23.2, C24.2, C25.2, C27.2, C28.2, C44.2, C45.2, C46.2, C53.2, C56.2, C68.2, C69.2, C70.2, C71.2, C72.2, C73.2, C74.2, C75.2, C76.2, C79.2, C80.2, D4.2, D6.2, D15.2, J2.3, J2.4, J2.11, J7.2, J8.2, J9.2, J11.2, J13.2, Q5.2, R34.2, R36.2, R42.2, R43.2, R44.2, R59.2, R79.2, TP16.1, TP16.2, U3.6, U3.9, U4.7, U4.9, U8.7, U8.9, U9.7, U9.9
