asrvsn/mmi/hardware/lid/heating_pcb/heating.kicad_pcb

## KiCad design hardware/lid/heating_pcb/heating.kicad_pcb (2026-11-12)

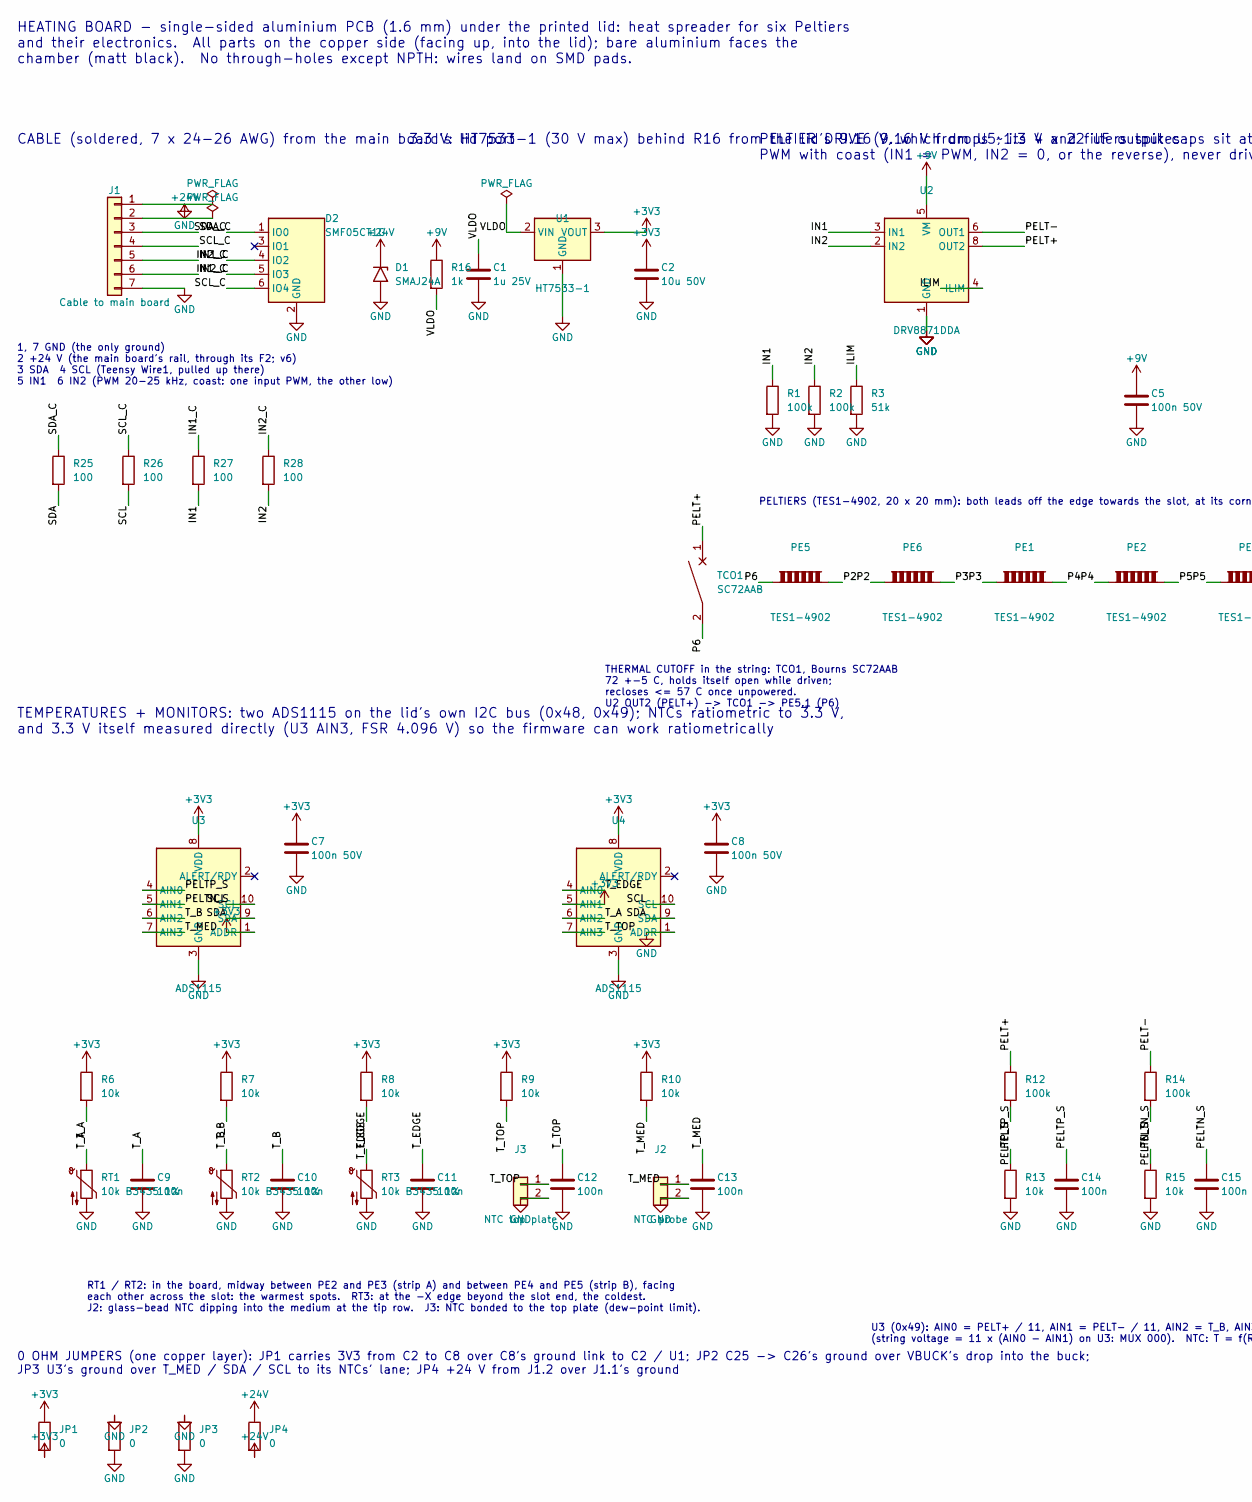
[picture p90: schematic heating.kicad_sch, Heating board: Peltier spreader (aluminium), part in row 1, column 1]

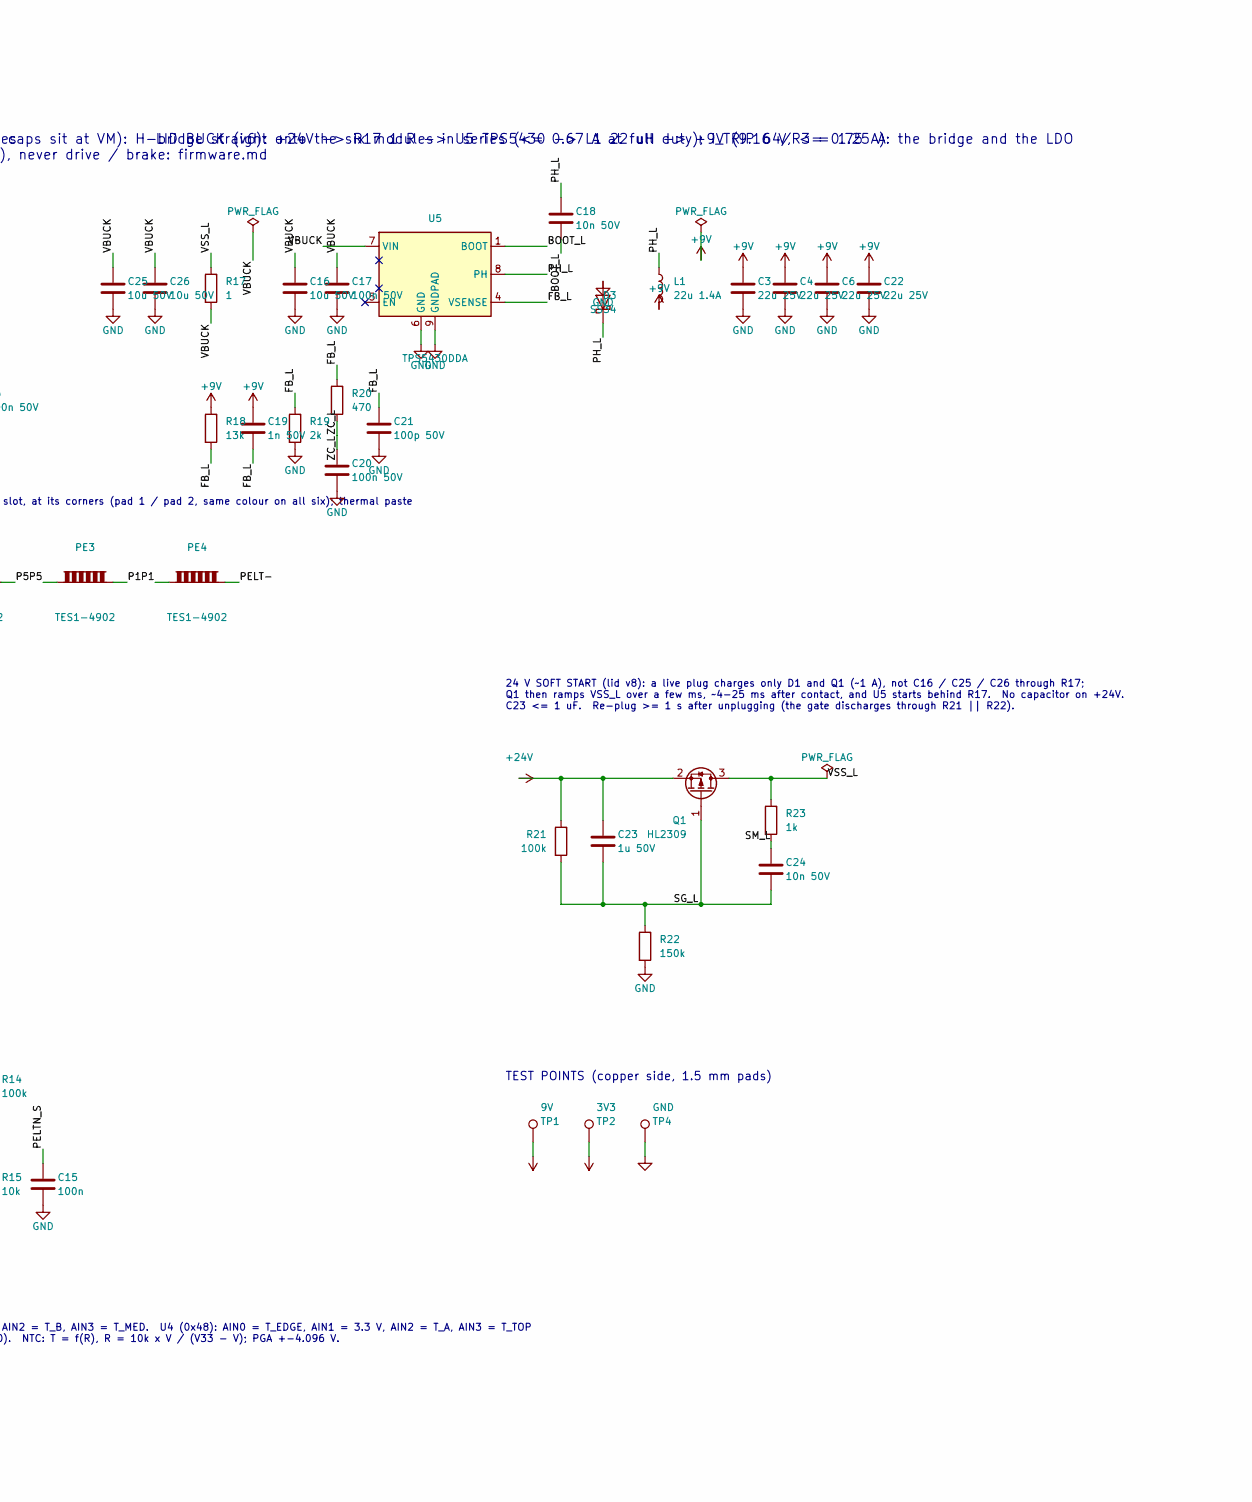
[picture p91: schematic heating.kicad_sch, Heating board: Peltier spreader (aluminium), part in row 1, column 2]

Parts:
C1: 1u 25V; C_0402_1005Metric; LCSC C52923
C2, C16, C25, C26: 10u 50V; C_1206_3216Metric; LCSC C13585
C3, C4, C6, C22: 22u 25V; C_1206_3216Metric; LCSC C12891
C5, C17, C20: 100n 50V; C_0402_1005Metric; LCSC C307331
C7, C8: 100n 50V; C_1206_3216Metric; LCSC C24497
C9, C10, C11, C12, C13, C14, C15: 100n; C_0402_1005Metric; LCSC C1525
C18: 10n 50V; C_0402_1005Metric; LCSC C15195
C19: 1n 50V; C_0402_1005Metric; LCSC C1523
C21: 100p 50V; C_0402_1005Metric; LCSC C1546
C23: 1u 50V; C_0603_1608Metric; LCSC C15849
C24: 10n 50V; C_0603_1608Metric; LCSC C57112
D1: SMAJ24A; D_SMA; LCSC C19077541
D2: SMF05CT1G; SOT-363_SC-70-6; LCSC C15879
D3: SS34; D_SMA; LCSC C8678
J1: Cable to main board; SolderPads_1x07_P1.8mm_Narrow_Hand
J2: NTC probe; SolderPads_1x02_P2.0mm_Hand
J3: NTC top plate; SolderPads_1x02_P2.0mm_Hand
JP1: 0; R_0603_1608Metric_Jumper; LCSC C21189
JP2, JP3, JP4: 0; R_1206_3216Metric_Jumper; LCSC C17888
L1: 22u 1.4A; L_Sunlord_SWPA6028S; LCSC C51349
PE1, PE2, PE3, PE4, PE5, PE6: TES1-4902; Peltier_20x20_LeadsInner_Hand
Q1: HL2309; SOT-23; LCSC C28646263
R1, R2, R12, R14: 100k; R_0402_1005Metric; LCSC C25741
R3: 51k; R_0402_1005Metric; LCSC C25794
R6, R7, R8, R9, R10, R13, R15: 10k; R_0402_1005Metric; LCSC C25744
R16: 1k; R_1206_3216Metric; LCSC C4410
R17: 1; R_1206_3216Metric; LCSC C17928
R18: 13k; R_0603_1608Metric; LCSC C22797
R19: 2k; R_0402_1005Metric; LCSC C4109
R20: 470; R_0402_1005Metric; LCSC C25117
R21: 100k; R_0603_1608Metric; LCSC C25803
R22: 150k; R_0603_1608Metric; LCSC C22807
R23: 1k; R_0603_1608Metric; LCSC C21190
R25, R27, R28: 100; R_0603_1608Metric; LCSC C22775
R26: 100; R_1206_3216Metric; LCSC C17901
RT1, RT2, RT3: 10k B3435 1%; R_0603_1608Metric; LCSC C13564
TCO1: SC72AAB; Bourns_SC_TCO; LCSC C2859510
TP1: 9V; TestPoint_Pad_D1.5mm
TP2: 3V3; TestPoint_Pad_D1.5mm
TP4: GND; TestPoint_Pad_D1.5mm
U1: HT7533-1; SOT-89-3; LCSC C14289
U2: DRV8871DDA; Texas_HTSOP-8-1EP_3.9x4.9mm_P1.27mm_EP2.95x4.9mm_NoVias; LCSC C75864
U3, U4: ADS1115; TSSOP-10_3x3mm_P0.5mm; LCSC C37593
U5: TPS5430DDA; TI_SO-PowerPAD-8; LCSC C9864

Connections:
+3V3: C2.1, C7.1, C8.1, JP1.1, JP1.2, R6.1, R7.1, R8.1, R9.1, R10.1, TP2.1, U1.3 (VOUT), U3.1 (ADDR), U3.8 (VDD), U4.5 (AIN1), U4.8 (VDD)
+9V: C3.1, C4.1, C5.1, C6.1, C19.1, C22.1, L1.2, R16.1, R18.1, TP1.1, U2.5 (VM)
+24V: C23.1, D1.1 (A1), J1.2, JP4.1, JP4.2, Q1.2 (S), R21.1
/BOOT_L: C18.2, U5.1 (BOOT)
/FB_L: C19.2, C21.1, R18.2, R19.1, R20.1, U5.4 (VSENSE)
/ILIM: R3.1, U2.4 (ILIM)
/IN1: R1.1, R27.2, U2.3 (IN1)
/IN1_C: D2.5 (IO3), J1.5, R27.1
/IN2: R2.1, R28.2, U2.2 (IN2)
/IN2_C: D2.4 (IO2), J1.6, R28.1
/P1: PE3.2, PE4.1
/P2: PE5.2, PE6.1
/P3: PE1.1, PE6.2
/P4: PE1.2, PE2.1
/P5: PE2.2, PE3.1
/P6: PE5.1, TCO1.2
/PELT+: R12.1, TCO1.1, U2.8 (OUT2)
/PELT-: PE4.2, R14.1, U2.6 (OUT1)
/PELTN_S: C15.1, R14.2, R15.1, U3.5 (AIN1)
/PELTP_S: C14.1, R12.2, R13.1, U3.4 (AIN0)
/PH_L: C18.1, D3.1 (K), L1.1, U5.8 (PH)
/SCL: R26.2, U3.10 (SCL), U4.10 (SCL)
/SCL_C: D2.6 (IO4), J1.4, R26.1
/SDA: R25.2, U3.9 (SDA), U4.9 (SDA)
/SDA_C: D2.1 (IO0), J1.3, R25.1
/SG_L: C23.2, C24.2, Q1.1 (G), R21.2, R22.1
/SM_L: C24.1, R23.2
/T_A: C9.1, R6.2, RT1.1, U4.6 (AIN2)
/T_B: C10.1, R7.2, RT2.1, U3.6 (AIN2)
/T_EDGE: C11.1, R8.2, RT3.1, U4.4 (AIN0)
/T_MED: C13.1, J2.1, R10.2, U3.7 (AIN3)
/T_TOP: C12.1, J3.1, R9.2, U4.7 (AIN3)
/VBUCK: C16.1, C17.1, C25.1, C26.1, R17.2, U5.7 (VIN)
/VLDO: C1.1, R16.2, U1.2 (VIN)
/VSS_L: Q1.3 (D), R17.1, R23.1
/ZC_L: C20.1, R20.2
GND: C1.2, C2.2, C3.2, C4.2, C5.2, C6.2, C7.2, C8.2, C9.2, C10.2, C11.2, C12.2, C13.2, C14.2, C15.2, C16.2, C17.2, C20.2, C21.2, C22.2, C25.2, C26.2, D1.2 (A2), D2.2 (GND), D3.2 (A), J1.1, J1.7, J2.2, J3.2, JP2.1, JP2.2, JP3.1, JP3.2, R1.2, R2.2, R3.2, R13.2, R15.2, R19.2, R22.2, RT1.2, RT2.2, RT3.2, TP4.1, U1.1 (GND), U2.1 (GND), U2.7 (GND), U2.9 (GND), U3.3 (GND), U4.1 (ADDR), U4.3 (GND), U5.6 (GND), U5.9 (GNDPAD)

Notes on the sheet:
HEATING BOARD - single-sided aluminium PCB (1.6 mm) under the printed lid: heat spreader for six Peltiers and their electronics. All parts on the copper side (facing up, into the lid); bare aluminium faces the chamber (matt black). No through-holes except NPTH: wires land on SMD pads.
THERMAL CUTOFF in the string: TCO1, Bourns SC72AAB 72 +-5 C, holds itself open while driven; recloses <= 57 C once unpowered. U2 OUT2 (PELT+) -> TCO1 -> PE5.1 (P6)
24 V SOFT START (lid v8): a live plug charges only D1 and Q1 (~1 A), not C16 / C25 / C26 through R17; Q1 then ramps VSS_L over a few ms, ~4-25 ms after contact, and U5 starts behind R17. No capacitor on +24V. C23 <= 1 uF. Re-plug >= 1 s after unplugging (the gate discharges through R21 || R22).
1, 7 GND (the only ground) 2 +24 V (the main board's rail, through its F2; v6) 3 SDA 4 SCL (Teensy Wire1, pulled up there) 5 IN1 6 IN2 (PWM 20-25 kHz, coast: one input PWM, the other low)
TEMPERATURES + MONITORS: two ADS1115 on the lid's own I2C bus (0x48, 0x49); NTCs ratiometric to 3.3 V, and 3.3 V itself measured directly (U3 AIN3, FSR 4.096 V) so the firmware can work ratiometrically
0 OHM JUMPERS (one copper layer): JP1 carries 3V3 from C2 to C8 over C8's ground link to C2 / U1; JP2 C25 -> C26's ground over VBUCK's drop into the buck; JP3 U3's ground over T_MED / SDA / SCL to its NTCs' lane; JP4 +24 V from J1.2 over J1.1's ground
TEST POINTS (copper side, 1.5 mm pads)
3.3 V: HT7533-1 (30 V max) behind R16 from the lid's 9.16 V, which drops ~1.3 V and filters spikes
PELTIERS (TES1-4902, 20 x 20 mm): both leads off the edge towards the slot, at its corners (pad 1 / pad 2, same colour on all six); thermal paste
U3 (0x49): AIN0 = PELT+ / 11, AIN1 = PELT- / 11, AIN2 = T_B, AIN3 = T_MED. U4 (0x48): AIN0 = T_EDGE, AIN1 = 3.3 V, AIN2 = T_A, AIN3 = T_TOP (string voltage = 11 x (AIN0 - AIN1) on U3: MUX 000). NTC: T = f(R), R = 10k x V / (V33 - V); PGA +-4.096 V.
PELTIER DRIVE (9.16 V from U5; its 4 x 22 uF output caps sit at VM): H-bridge straight onto the six modules in series (<= 0.67 A at full duty); I_TRIP 64/R3 = 1.25 A PWM with coast (IN1 = PWM, IN2 = 0, or the reverse), never drive / brake: firmware.md
LID BUCK (v6): +24V -> R17 1 R -> U5 TPS5430 -> L1 22 uH -> +9V (9.16 V, <= 0.75 A): the bridge and the LDO
RT1 / RT2: in the board, midway between PE2 and PE3 (strip A) and between PE4 and PE5 (strip B), facing each other across the slot: the warmest spots. RT3: at the -X edge beyond the slot end, the coldest. J2: glass-bead NTC dipping into the medium at the tip row. J3: NTC bonded to the top plate (de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
CABLE (soldered, 7 x 24-26 AWG) from the main board's lid port

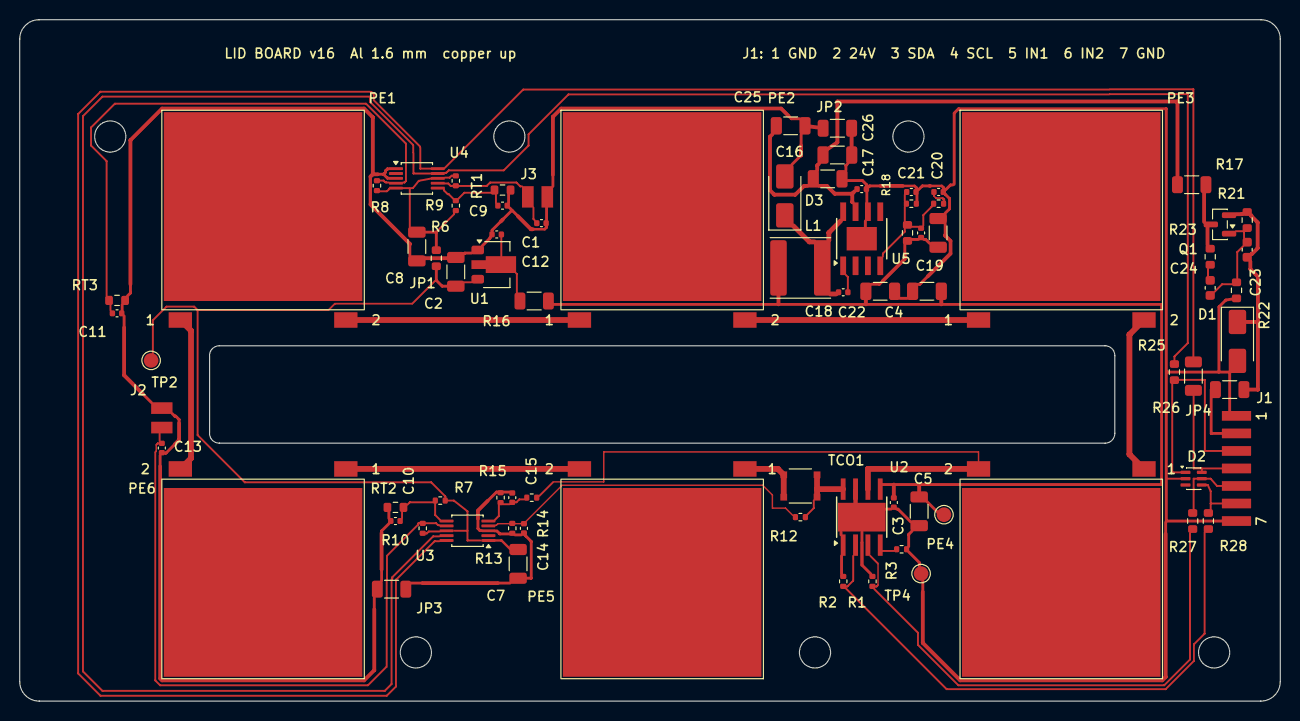
[picture p92: board heating.kicad_pcb from above]

Board: 2 copper layers, 129.5 x 70.0 mm, 86 parts (0 on the bottom side), 37 nets.

Other parts of the board:
MH1, MH2, MH3, MH4, MH5, MH6: M3; MountingHole_3.2mm_M3
