asrvsn/mmi/hardware/frame/main_pcb/main.kicad_pcb

## KiCad design hardware/frame/main_pcb/main.kicad_pcb (2026-11-12)

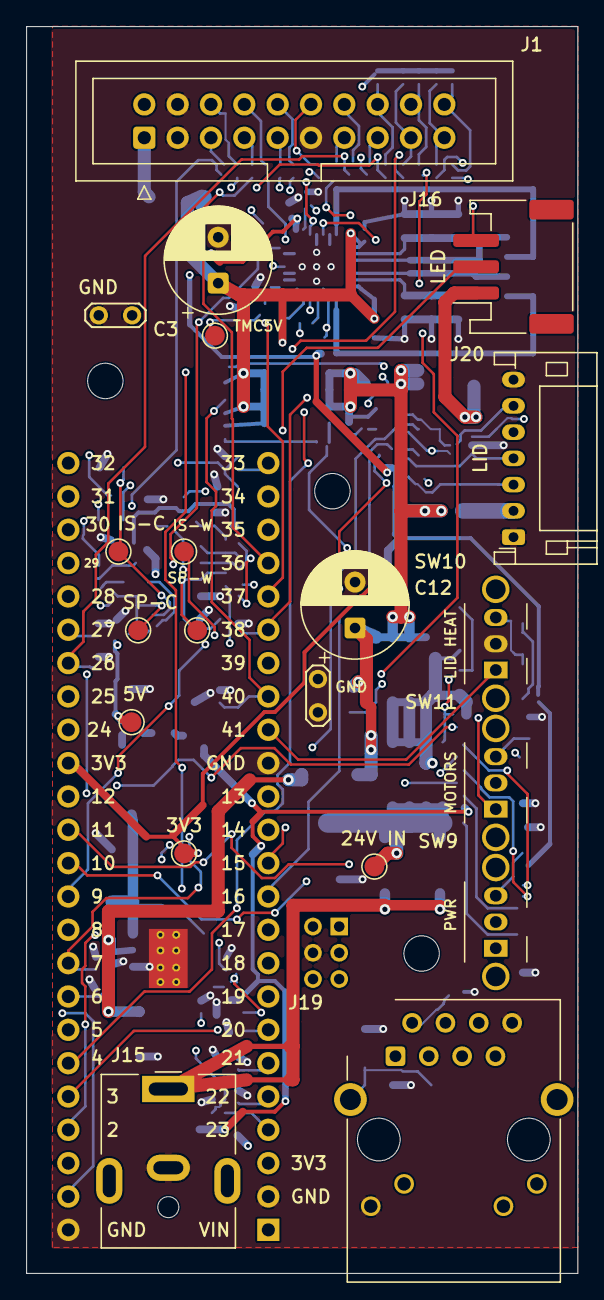
[picture p93: board main.kicad_pcb from above]

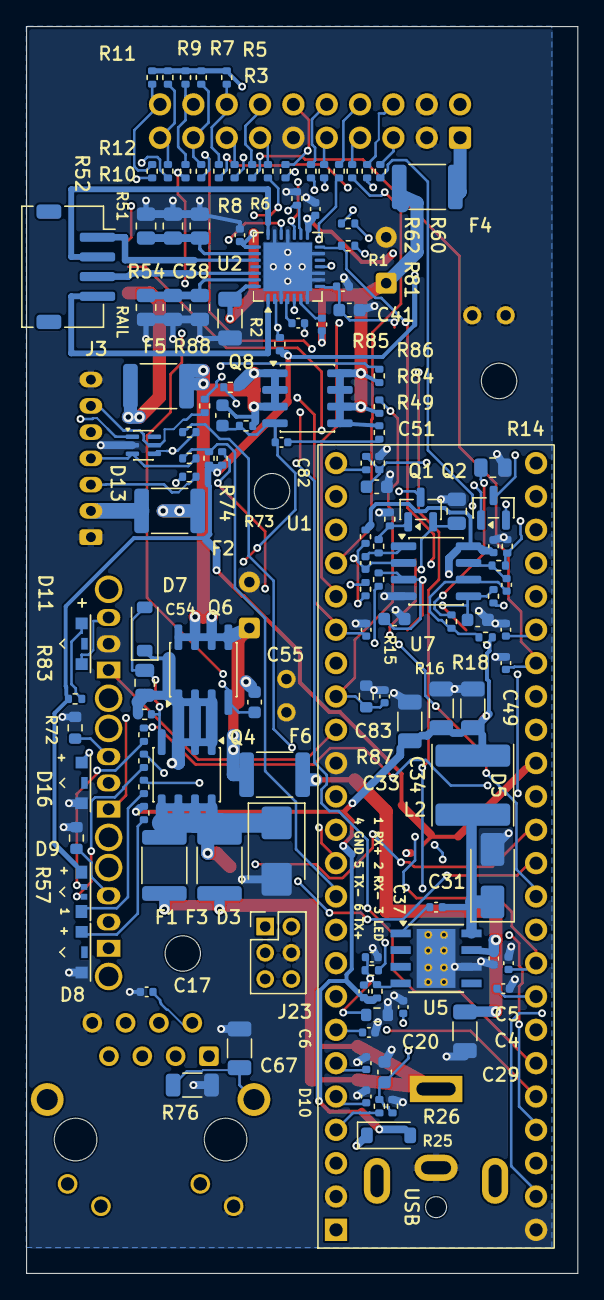
[picture p94: board main.kicad_pcb from below]

Board: 4 copper layers, 42.0 x 95.0 mm, 158 parts (135 on the bottom side), 113 nets.

Parts:
C2, C17, C30, C36, C39, C82: 100n 50V; C_0402_1005Metric
C3, C12: 100u 50V; CP_Radial_D8.0mm_P3.50mm
C4, C5, C6, C7, C8, C13, C14, C15, C42, C43, C83: 100n; C_0402_1005Metric
C20, C50, C51, C52: 470n 25V; C_0603_1608Metric
C29, C38: 10u 50V; C_1206_3216Metric
C31, C47, C48, C49: 10n 50V; C_0402_1005Metric
C32, C33, C34: 22u 25V; C_1206_3216Metric
C35: 1n 50V; C_0402_1005Metric
C37: 100p 50V; C_0402_1005Metric
C40: 22n 50V; C_0402_1005Metric
C41: 4u7 16V; C_0603_1608Metric
C54: 2u2 50V; C_0805_2012Metric
C55: 47n 50V; C_0603_1608Metric
C67: 1n 2kV; C_1206_3216Metric
C81: 1u 50V; C_0603_1608Metric
D3: SMBJ24CA; D_SMB
D5: SS34; D_SMA
D7: BZT52C12; D_SOD-123
D8: XL-3210UGC; LED_SideView_XL-3210
D9: XL-3210RGBC-YG; LED_RGB_SideView_XL-3210RGBC
D10: B5819W; D_SOD-123
D11: XL-3210SURC; LED_SideView_XL-3210
D13: SMF05CT1G; SOT-363_SC-70-6
D16: XL-3210UYC; LED_SideView_XL-3210
F1, F2, F3, F4: PTC 1.1 A 33 V; Fuse_1812_4532Metric
F5, F6: PTC 0.5 A 30 V; Fuse_1812_4532Metric
J1: Ribbon header 2x10 (vertical, shrouded); IDC-Header_2x10_P2.54mm_Vertical
J3: Rail motor (ZH); JST_ZH_S4B-ZR-SM4A-TF_1x04-1MP_P1.50mm_Horizontal
J15: 24 V in; BarrelJack_CUI_PJ-063AH_Horizontal
J16: LED strip (JST PH); JST_PH_S3B-PH-SM4-TB_1x03-1MP_P2.00mm_Horizontal
J19: RJ45 MagJack (J1B1211CCD); RJ45_Cetus_J1B1211CCD_Horizontal
J20: Lid port (JST PH, 7); JST_PH_S7B-PH-K_1x07_P2.00mm_Horizontal
J23: ETH (kit cable); PinHeader_2x03_P2.00mm_Vertical
L2: 22u 2.05A; L_Sunlord_SWPA6045S
MH1, MH2, MH3: M2.5; MountingHole_2.7mm_M2.5
Q1, Q2: HL2310A; SOT-23
Q4, Q6, Q8: AO4485; SOIC-8_3.9x4.9mm_P1.27mm
R1, R4, R6, R8, R10, R12, R15, R16, R19, R20, R60, R61, R62, R63, R64, R65, R67, R72, R77, R84, R88: 1k; R_0402_1005Metric
R2, R25, R28, R45, R46, R47, R48, R50: 10k; R_0402_1005Metric
R3, R5, R7, R9, R11: 2k; R_0402_1005Metric
R13, R14: 49.9; R_0805_2012Metric
R17, R18, R56: 1M; R_0402_1005Metric
R21, R22, R55, R82, R86: 100k; R_0402_1005Metric
R26, R49: 15k; R_0402_1005Metric
R29, R30, R31, R32: 100; R_0402_1005Metric
R37: 12k; R_0402_1005Metric
R38: 3k9; R_0603_1608Metric
R39, R68, R69: 470; R_0402_1005Metric
R40, R41, R51, R52, R53, R54: 1R 0805; R_0805_2012Metric
R57: 470k; R_0603_1608Metric
R66, R73, R74: 2k2; R_0402_1005Metric
R76: 1M; R_1206_3216Metric
R81, R85: 22k; R_0402_1005Metric
R83: 150k; R_0603_1608Metric
R87: 13k; R_0603_1608Metric
SW9, SW10, SW11: C&K SK-12D07-VG 4 NS PA; SW_Slide_SPDT_Angled_SK-12D07_H8
TP1: 24V IN; TestPoint_Pad_D1.5mm
TP2: 5V; TestPoint_Pad_D1.5mm
TP3: 3V3; TestPoint_Pad_D1.5mm
TP4, TP5: GND; TestPoint_2Pads_Pitch2.54mm_Drill0.8mm
TP6: TMC5V; TestPoint_Pad_D1.5mm
TP7: SP-W; TestPoint_Pad_D1.5mm
TP8: SP-C; TestPoint_Pad_D1.5mm
TP9: IS-W; TestPoint_Pad_D1.5mm
TP10: IS-C; TestPoint_Pad_D1.5mm
U1: Teensy 4.1; Teensy41_Ethernet
U2: TMC2209-LA; VQFN-28-1EP_5x5mm_P0.5mm_EP3.7x3.7mm
U5: TPS5430DDA; TI_SO-PowerPAD-8_ThermalVias
U7: MCP6002T-I/SN; SOIC-8_3.9x4.9mm_P1.27mm

Connections:
+3V3: C43.1, D9.2, R2.1, R3.1, R5.1, R7.1, R9.1, R11.1, R72.1, R73.1, R74.1, TP3.1, U1.3V3, U2.15
+5V: C13.1, C32.1, C33.1, C34.1, C35.1, D10.2, L2.2, R17.2, R18.2, R37.1, R66.1, TP2.1, U7.8
+24V: C12.1, C55.2, C81.2, F2.1, F5.1, F6.1, Q6.5, Q6.6, Q6.7, Q6.8, Q8.1, Q8.2, Q8.3, R82.2, R88.2
/DAC_C: C52.1, R50.2, TP8.1, U7.5
/DAC_W: C50.1, R28.2, TP7.1, U7.3
/DIAG: U1.5, U2.11
/DIM_C: R48.1, U1.33
/DIM_W: R25.1, U1.23
/DIR: U1.3, U2.19
/EN: R2.2, U1.4, U2.2
/ETH_CT: C17.1, J19.2, J19.5
/ETH_LED: J19.10, J23.3
/ETH_RX+: J19.4, J23.1
/ETH_RX-: J19.6, J23.2
/ETH_TX+: J19.1, J23.6
/ETH_TX-: J19.3, J23.5
/FB5: C35.2, C37.1, R37.2, R38.1, R39.1, U5.4
/HEAD_24V: F4.2, J1.1, J1.2
/ISNS_C: Q2.2, R14.1, R16.2, TP10.1
/ISNS_W: Q1.2, R13.1, R15.2, TP9.1
/LED_24V: F5.2, J16.1
/LED_B: R69.2, U1.12
/LED_C-: J16.3, Q2.3
/LED_G: R68.2, U1.11
/LED_R: R67.2, U1.10
/LED_W-: J16.2, Q1.3
/LID_24V: F2.2, J20.2
/LID_IN1: R31.1, U1.14
/LID_IN1_P: D13.4, J20.5, R31.2
/LID_IN2: R32.1, U1.15
/LID_IN2_P: D13.5, J20.6, R32.2
/LID_SW: SW10.1, U1.41
/LIM_MAX: C5.1, R6.1, U1.7
/LIM_MIN: C4.1, R4.1, U1.6
/LIM_X: C6.1, R8.1, U1.20
/LIM_Y: C7.1, R10.1, U1.21
/LIM_Z: C8.1, R12.1, U1.22
/MOT_24V: C2.1, C3.1, C38.1, C39.1, F4.1, Q8.5, Q8.6, Q8.7, Q8.8, R84.1, R85.1, R86.1, U2.22, U2.28
/MOT_G: C81.1, C82.2, Q8.4, R82.1, SW11.2
/MOT_LED: D16.2, R85.2
/MOT_M: C82.1, R84.2
/MOT_ON: C83.1, R86.2, R87.1, U1.40
/MX_I: C47.1, R45.2, U1.27
/MX_IN1: R60.1, U1.28
/MX_IN1_C: J1.5, R60.2
/MX_IN2: R61.1, U1.29
/MX_IN2_C: J1.6, R61.2
/MX_IP: J1.12, R45.1
/MY_I: C48.1, R46.2, U1.38
/MY_IN1: R62.1, U1.36
/MY_IN1_C: J1.7, R62.2
/MY_IN2: R63.1, U1.37
/MY_IN2_C: J1.8, R63.2
/MY_IP: J1.13, R46.1
/MZ_I: C49.1, R47.2, U1.26
/MZ_IN1: R64.1, U1.24
/MZ_IN1_C: J1.9, R64.2
/MZ_IN2: R65.1, U1.25
/MZ_IN2_C: J1.10, R65.2
/MZ_IP: J1.14, R47.1
/PH_5V: C31.1, D5.1, L2.1, U5.8
/PWR_G: C54.2, C55.1, D7.2, Q4.4, Q6.4, R56.2, SW9.2
/PWR_IN: D3.1, F1.2, F3.2, Q4.5, Q4.6, Q4.7, Q4.8, TP1.1
/PWR_S: C54.1, D7.1, Q4.1, Q4.2, Q4.3, Q6.1, Q6.2, Q6.3, R56.1, SW9.1
/RAIL_A1: J3.1, U2.24
/RAIL_A2: J3.2, U2.21
/RAIL_B1: J3.3, U2.26
/RAIL_B2: J3.4, U2.1
/SCL1: R30.1, R74.2, U1.16
/SCL1_P: D13.3, J20.4, R30.2
/SDA1: R29.1, R73.2, U1.17
/SDA1_P: D13.1, J20.3, R29.2
/SENSE_A: R40.1, R51.1, R52.1, U2.23
/SENSE_B: R41.1, R53.1, R54.1, U2.27
/STEP: R55.1, U1.2, U2.16
/SW10_ON: D11.1, SW10.3
/SW11_OFF: R88.1, SW11.1
/SW11_ON: R83.1, SW11.3
/SW_MAX: J1.17, R5.2, R6.2
/SW_MIN: J1.16, R3.2, R4.2
/SW_X: J1.18, R7.2, R8.2
/SW_Y: J1.19, R9.2, R10.2
/SW_Z: J1.20, R11.2, R12.2
/TMC_5V: C41.1, C42.1, R81.2, TP6.1, U2.8
/UART_RX: R1.2, U1.0, U2.14
/UART_TX: R1.1, U1.1
/V9_OFF: R77.1, U1.9
/V9_OFF_C: J1.15, R77.2
/VIN5: C29.1, C30.1, F6.2, U5.7
/VIN_JACK: F1.1, F3.1, J15.1
/VIN_T: D10.1, U1.VIN
GND: C2.2, C3.2, C4.2, C5.2, C6.2, C7.2, C8.2, C12.2, C13.2, C17.2, C20.2, C29.2, C30.2, C32.2, C33.2, C34.2, C36.2, C37.2, C38.2, C41.2, C42.2, C43.2, C47.2, C48.2, C49.2, C50.2, C51.2, C52.2, C67.2, C83.2, D3.2, D5.2, D8.1, D13.2, D16.1, J1.3, J1.4, J1.11, J15.2, J19.8, J19.9, J20.1, J20.7, J23.4, R13.2, R14.2, R21.2, R22.2, R26.2, R38.2, R40.2, R41.2, R49.2, R51.2, R52.2, R53.2, R54.2, R55.2, R57.2, R76.2, R83.2, R87.2, SW10.2, TP4.1, TP4.2, TP5.1, TP5.2, U1.GND, U2.3, U2.7, U2.9, U2.10, U2.13, U2.18, U2.20, U2.29, U5.6, U5.9, U7.4
unnamed: C14.2, R19.1, U7.1
unnamed: C15.2, R20.1, U7.7
unnamed: C20.1, R25.2, R26.1, R28.1
unnamed: C36.1, R39.2
unnamed: C51.1, R48.2, R49.1, R50.1
unnamed: D8.2, R66.2
unnamed: D9.4, R69.1
unnamed: D9.3, R68.1
unnamed: D9.1, R67.1
unnamed: D11.2, R72.2
unnamed: C67.1, J19.13, R76.1
unnamed: Q1.1, R19.2, R21.1
unnamed: Q2.1, R20.2, R22.1
unnamed: R57.1, SW9.3
unnamed: C40.2, U2.5
unnamed: C40.1, U2.4
unnamed: C39.2, U2.6
unnamed: R81.1, U2.17
unnamed: C31.2, U5.1
unnamed: C14.1, R15.1, R17.1, U7.2
unnamed: C15.1, R16.1, R18.1, U7.6
